thgeorgiou/ai-copy-stand/samples/README.md

# samples/

## quickrelease.stl

- **Model:** "Tripod quick release plate"
- **Author:** unwohlpol
- **Source:** <https://www.printables.com/model/204259-tripod-quick-release-plate>
- **License:** [CC BY-NC-SA 4.0](https://creativecommons.org/licenses/by-nc-sa/4.0/):
  credit the author, no commercial use, and adaptations must be shared under
  the same license.
- **Changes:** none. The file is included unmodified.

It's used only as a fitting reference. `vitamins.scad` imports it so the
clamp can be checked against a real plate profile. This file is not covered
by the project's CC0 dedication.

The clamp was designed to the plate's dimensions; it doesn't copy or adapt
this model. The rest of the project doesn't need this file, except to draw
the plate in previews. If you sell anything made from this project, leave
this file out.
