thgeorgiou/ai-copy-stand/renders/carriage_detail.png

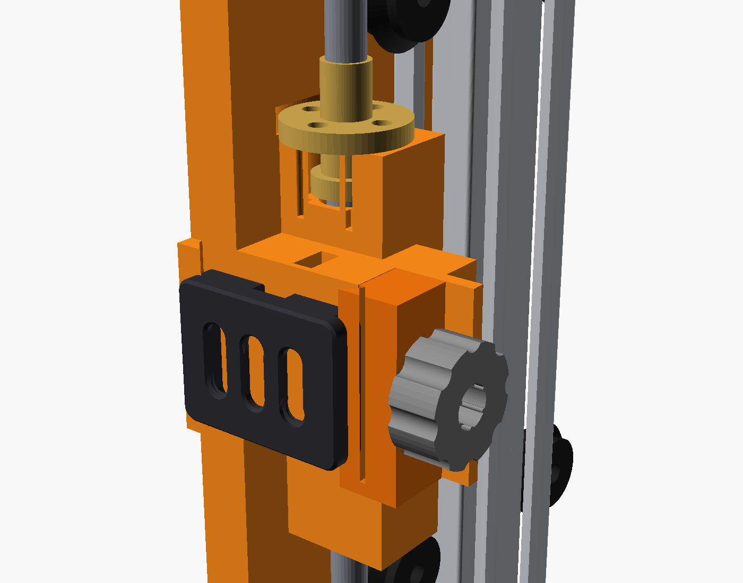
renders/carriage_detail.png
