thgeorgiou/ai-copy-stand/renders/carriage_top.png

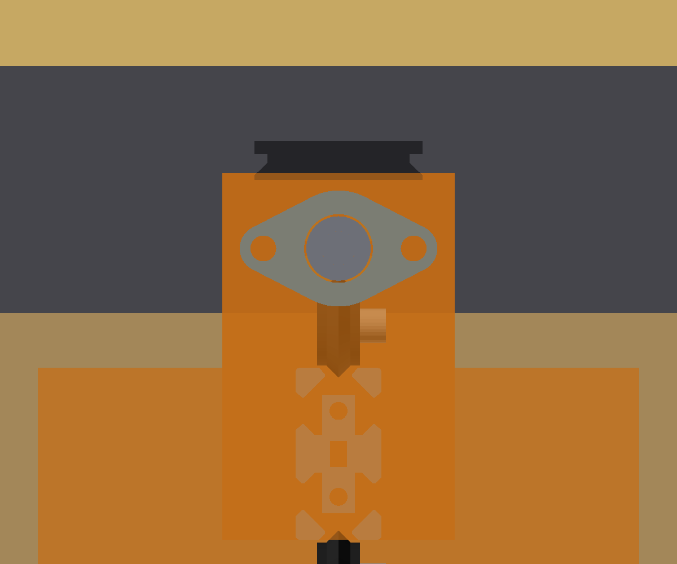
renders/carriage_top.png
