thgeorgiou/ai-copy-stand/renders/p0_coupons.png

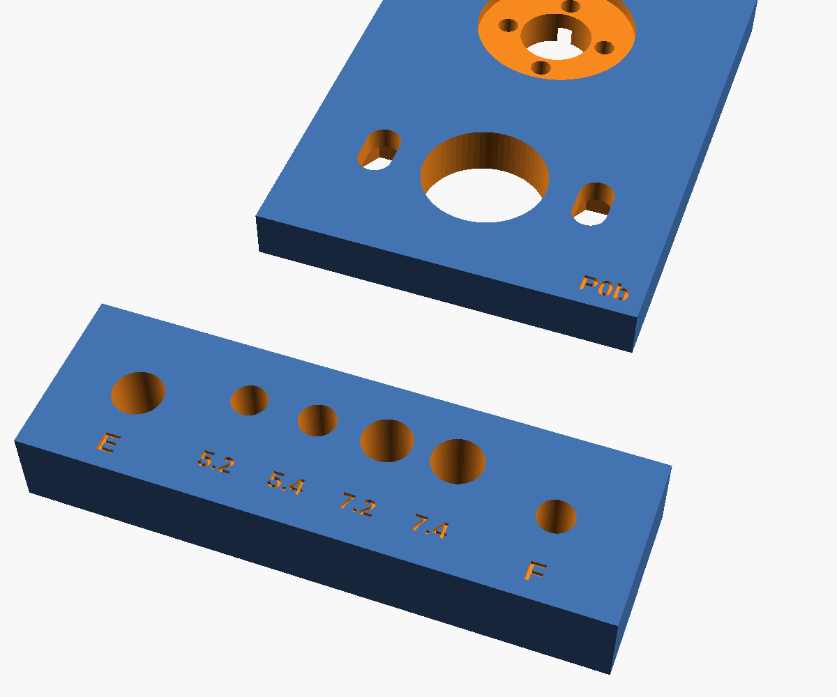
renders/p0_coupons.png
