thgeorgiou/ai-copy-stand/renders/p0_coupons_bottom.png

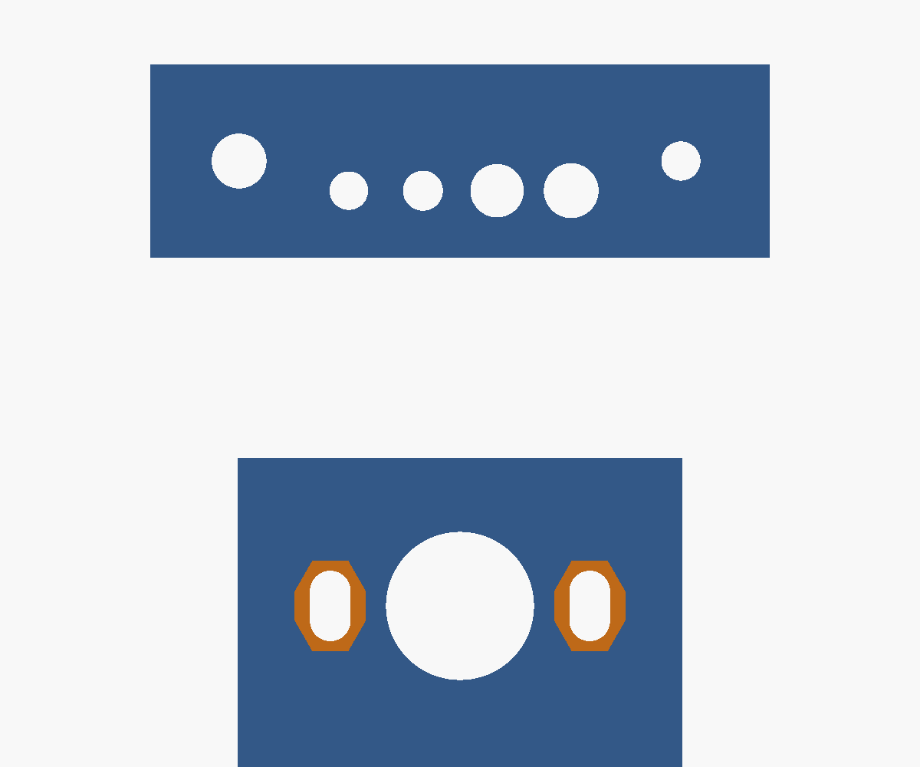
renders/p0_coupons_bottom.png
