thgeorgiou/ai-copy-stand/renders/p0a2.png

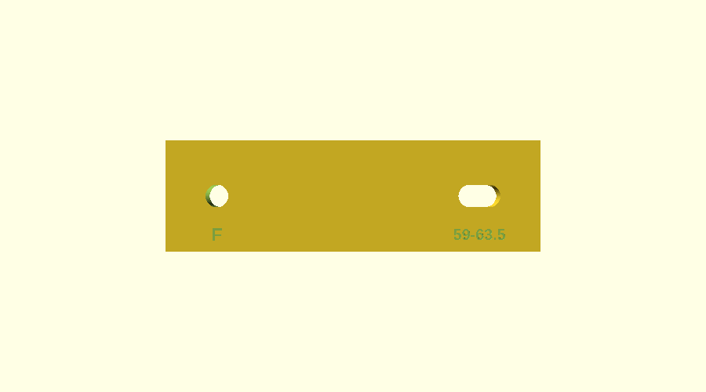
renders/p0a2.png
