thgeorgiou/ai-copy-stand/renders/p0c_end.png

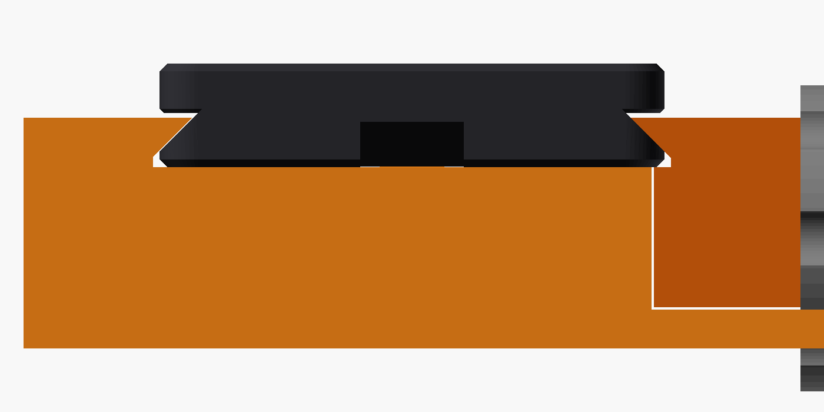
renders/p0c_end.png
