thgeorgiou/ai-copy-stand/renders/p0c_preview.png

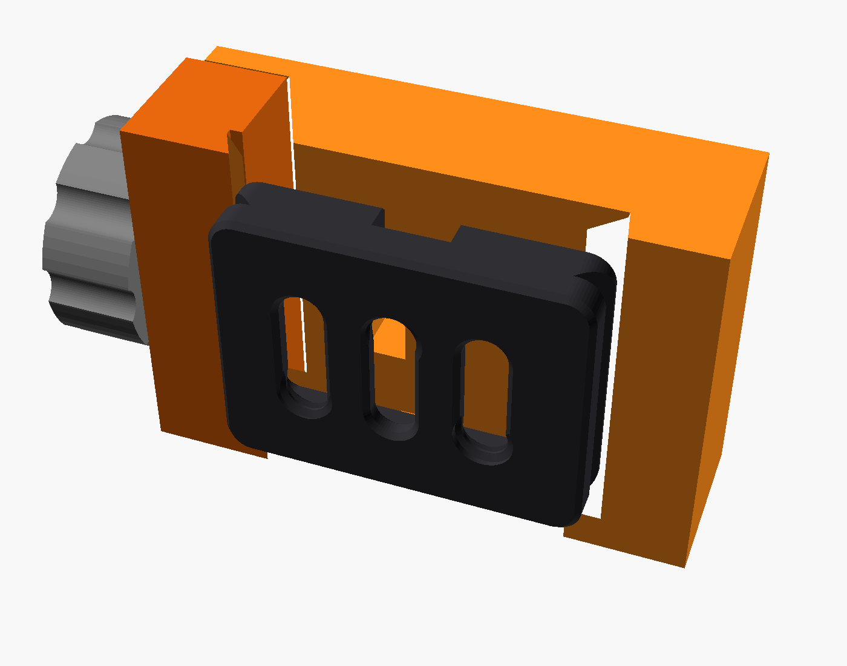
renders/p0c_preview.png
