thgeorgiou/ai-copy-stand/renders/p1_back.png

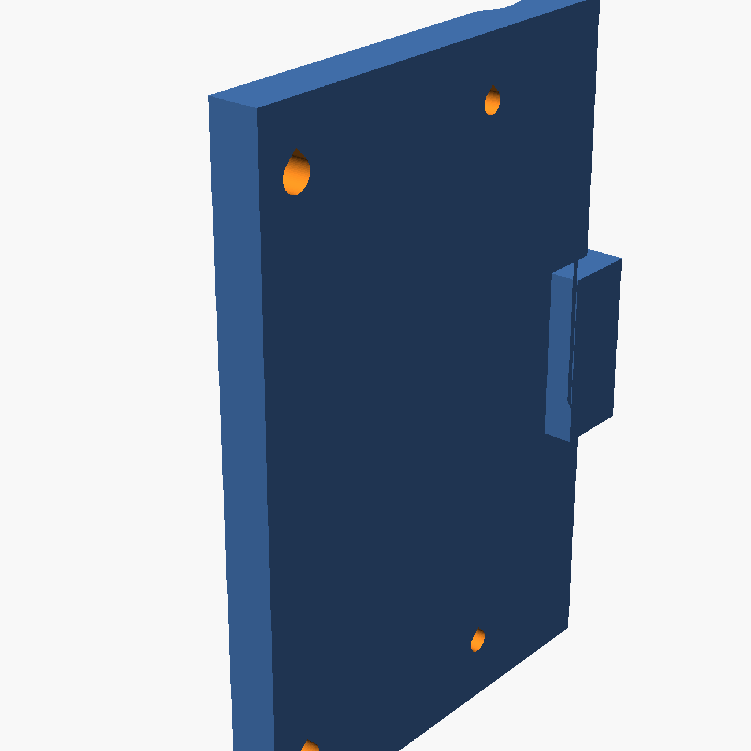
renders/p1_back.png
