thgeorgiou/ai-copy-stand/renders/p1_front.png

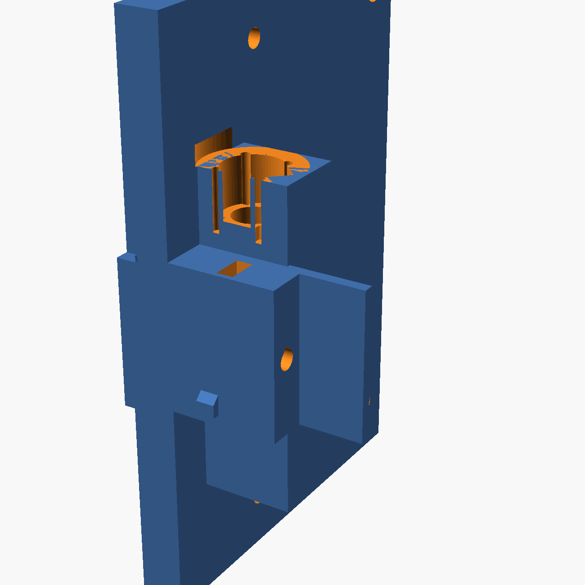
renders/p1_front.png
