thgeorgiou/ai-copy-stand/renders/p1_top.png

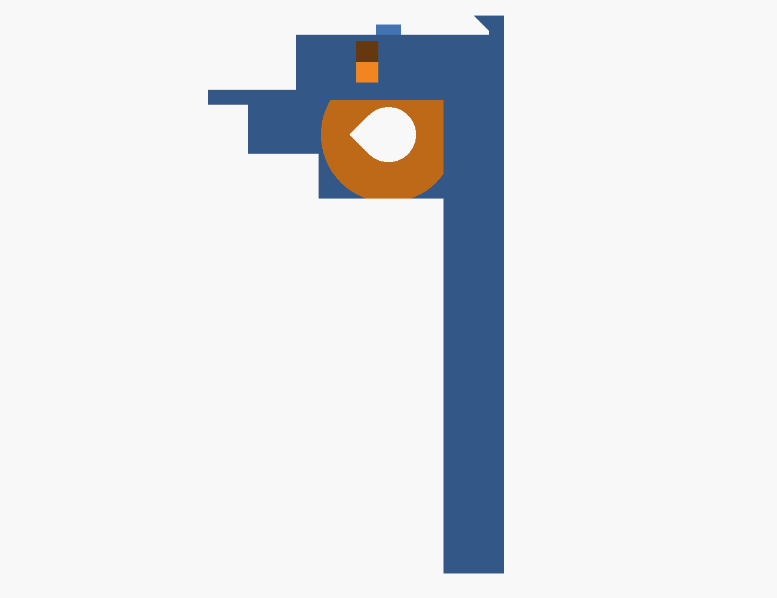
renders/p1_top.png
