thgeorgiou/ai-copy-stand/renders/p5_bottom_in_place.png

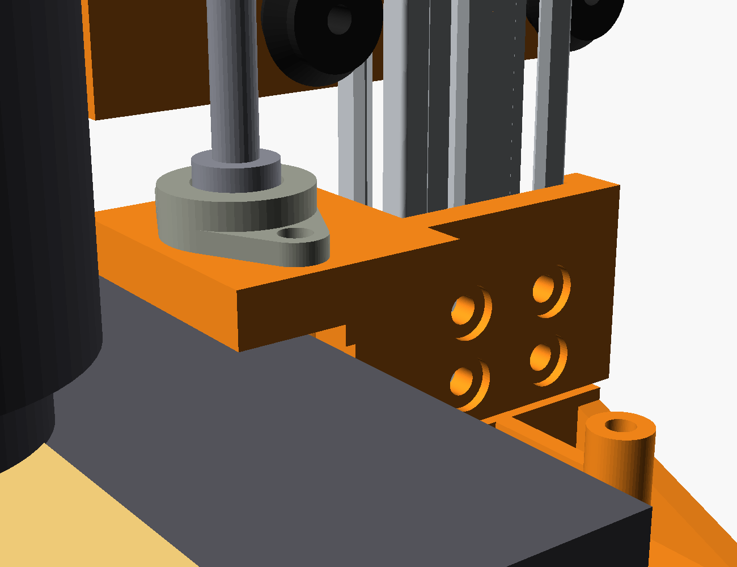
renders/p5_bottom_in_place.png
