thgeorgiou/ai-copy-stand/renders/p5_bracket.png

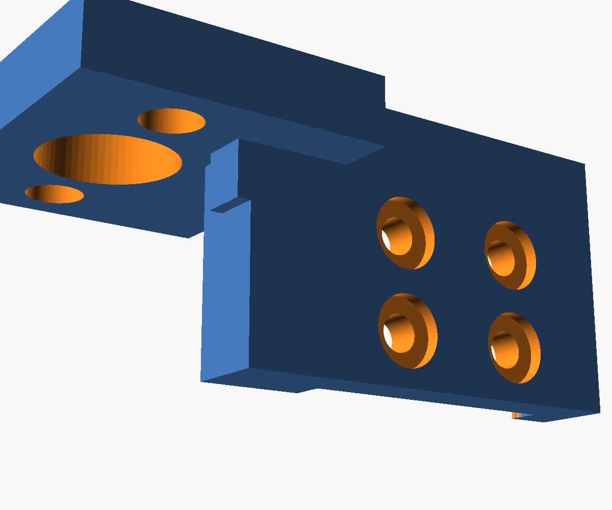
renders/p5_bracket.png
