thgeorgiou/ai-copy-stand/renders/p5_bracket_under.png

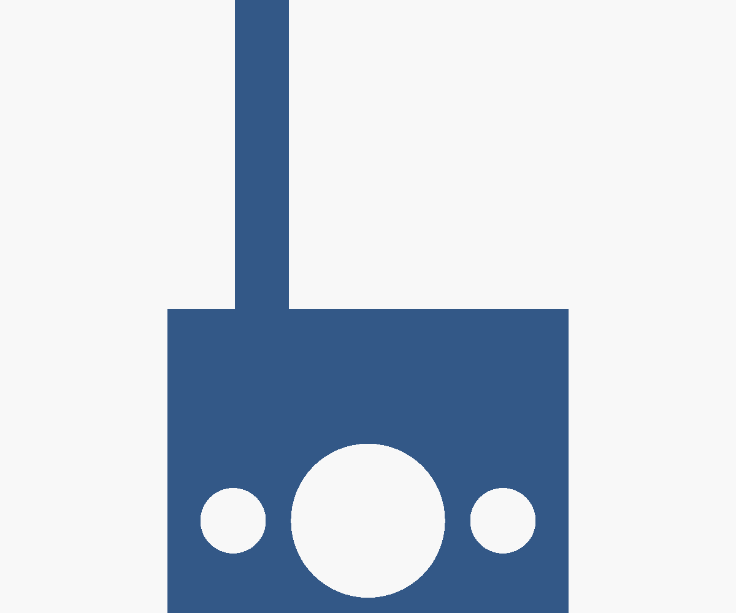
renders/p5_bracket_under.png
