thgeorgiou/ai-copy-stand/renders/p5_top_in_place.png

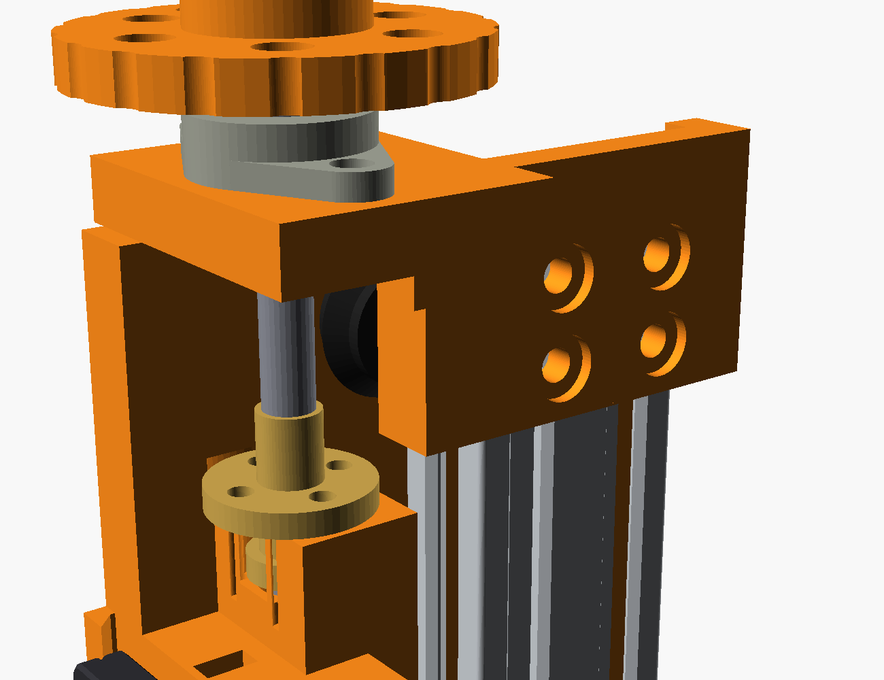
renders/p5_top_in_place.png
