thgeorgiou/ai-copy-stand/renders/p6_foot.png

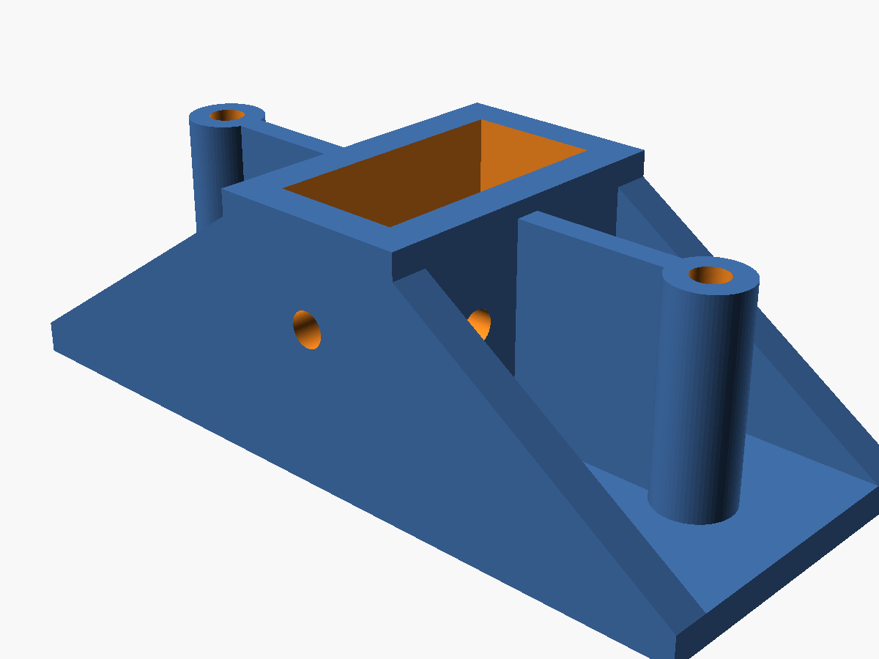
renders/p6_foot.png
