thgeorgiou/ai-copy-stand/renders/p7_handwheel.png

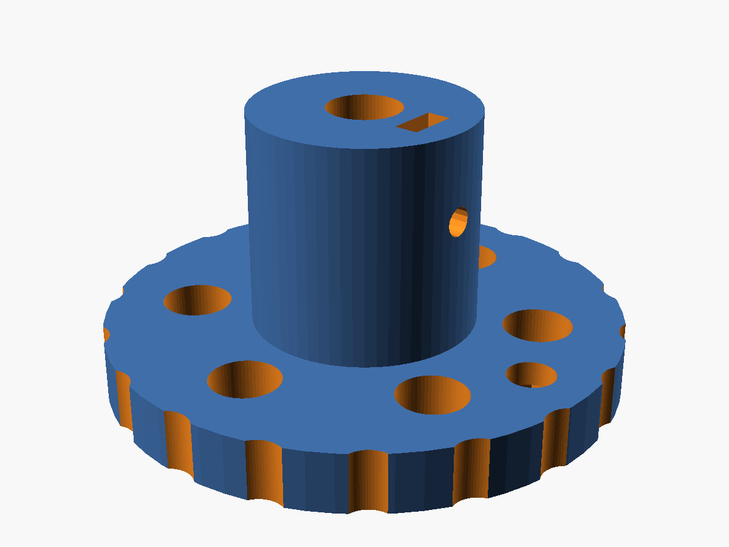
renders/p7_handwheel.png
