thgeorgiou/ai-copy-stand/renders/p7_handwheel_bottom.png

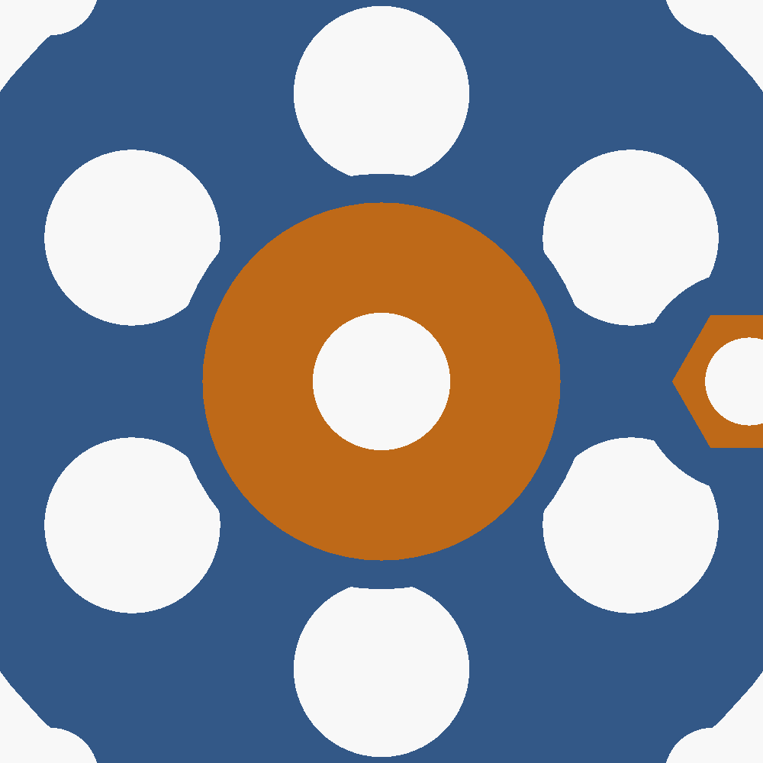
renders/p7_handwheel_bottom.png
