thgeorgiou/ai-copy-stand/renders/qr_end.png

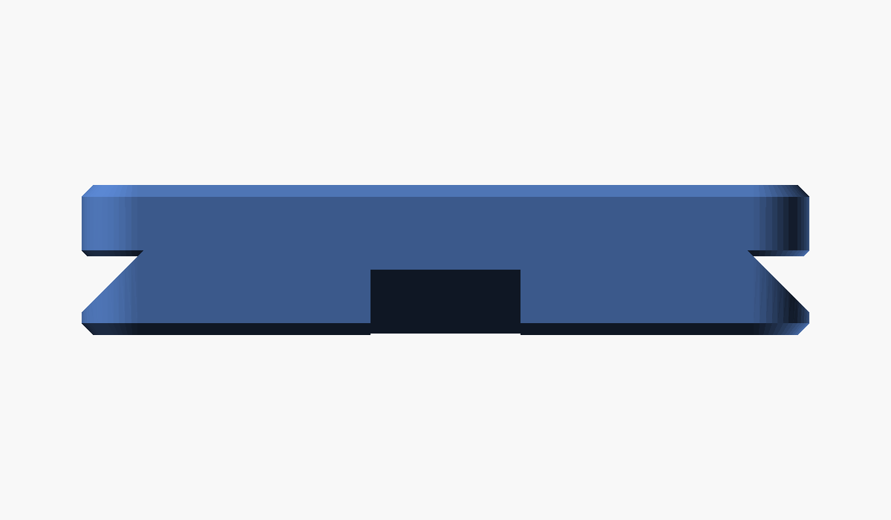
renders/qr_end.png
