thgeorgiou/ai-copy-stand/renders/qr_iso_bottom.png

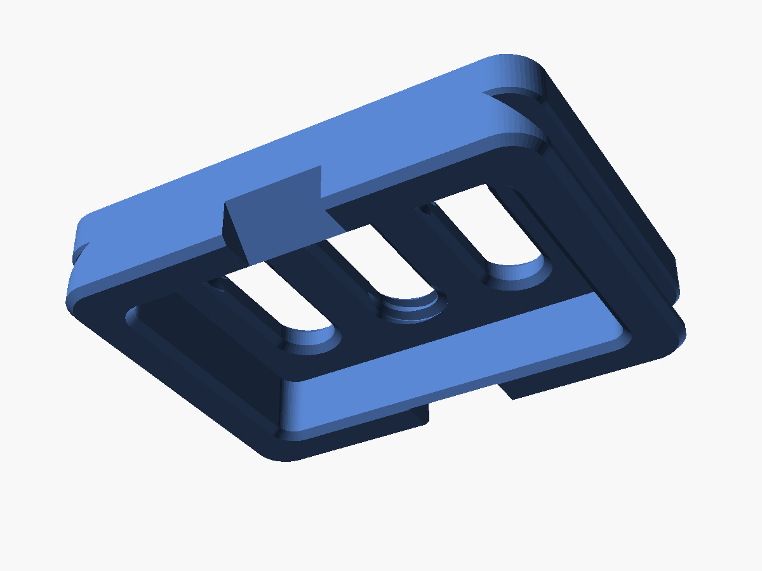
renders/qr_iso_bottom.png
