thgeorgiou/ai-copy-stand/renders/qr_iso_top.png

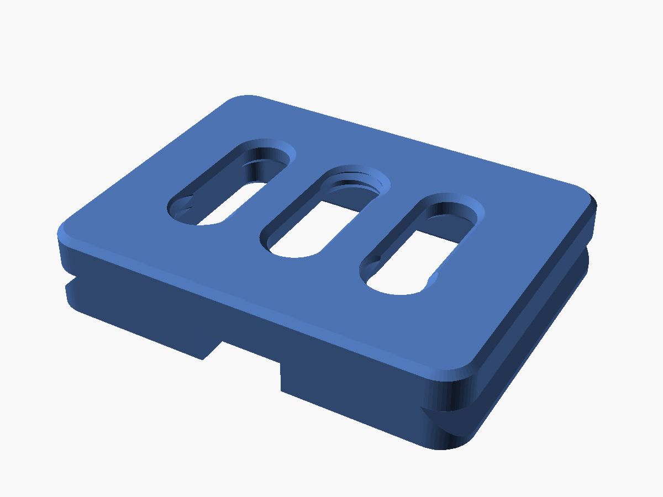
renders/qr_iso_top.png
