thgeorgiou/ai-copy-stand/renders/qr_sections.png

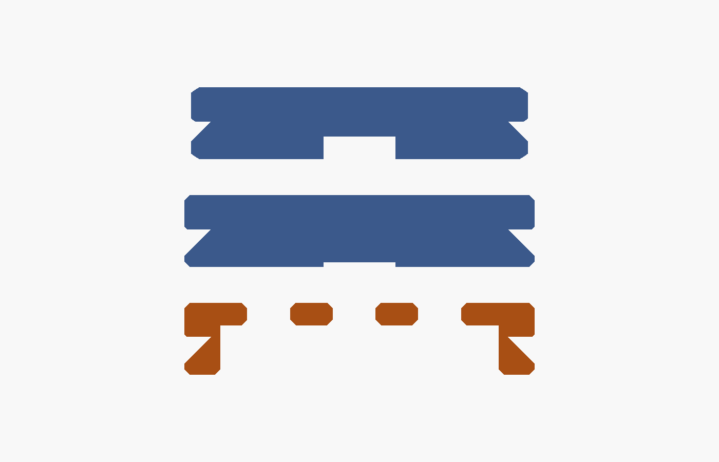
renders/qr_sections.png
