thgeorgiou/ai-copy-stand/samples/quickrelease.stl

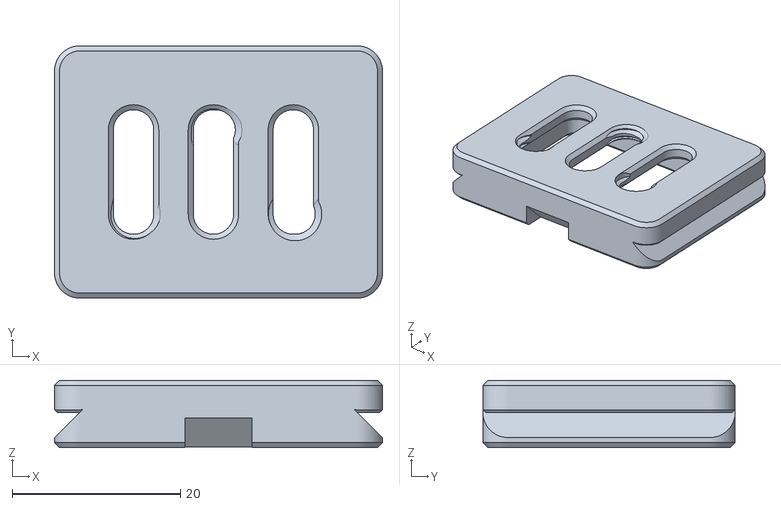
[picture p23: CAD file, 2026-10-19]
samples/quickrelease.stl
39.0 x 30.0 x 8.00
