thgeorgiou/ai-copy-stand/stl/p8_board_feet.stl

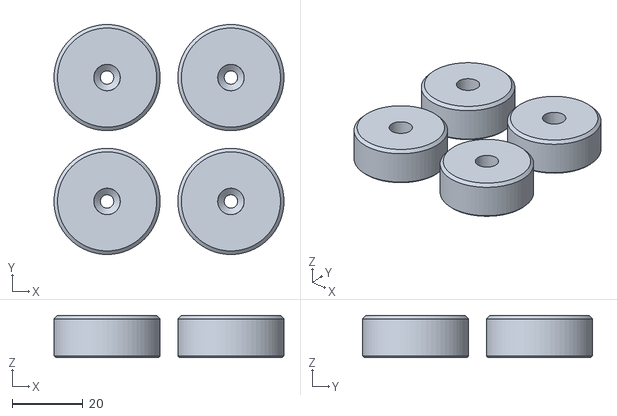
[picture p24: CAD file, 2026-10-31]
stl/p8_board_feet.stl
65.0 x 65.0 x 12.0
