thgeorgiou/ai-copy-stand/stl/p1_carriage.stl

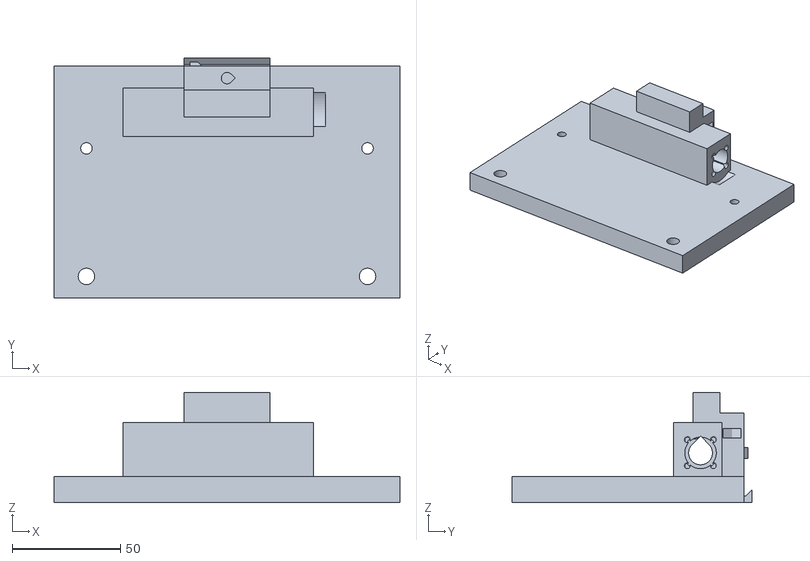
[picture p25: CAD file, 2026-10-31]
stl/p1_carriage.stl
160.0 x 111.0 x 51.0
