thgeorgiou/ai-copy-stand/stl/p3_p4_jaw_knob.stl

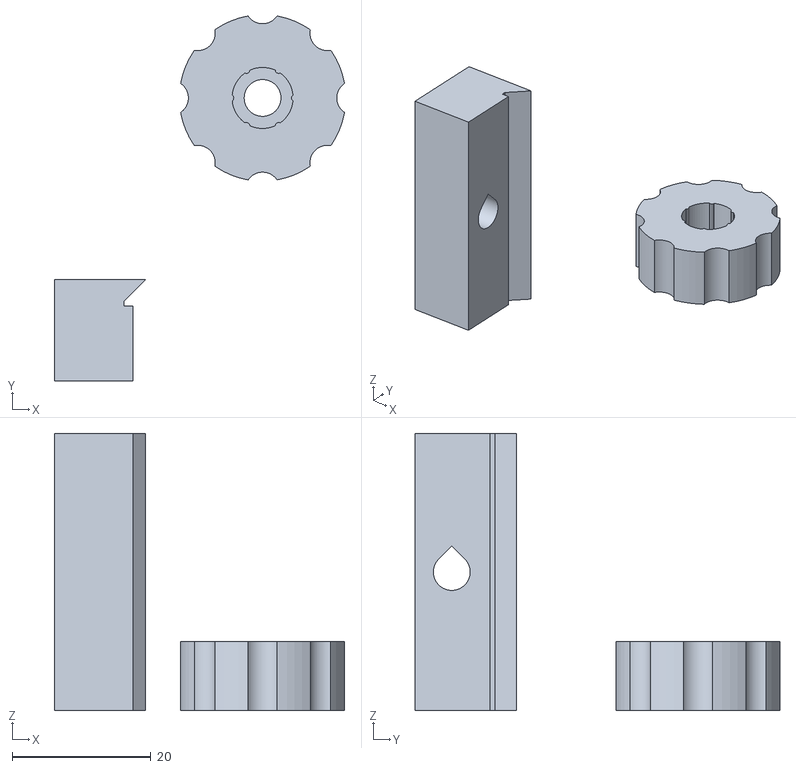
[picture p26: CAD file, 2026-10-19]
stl/p3_p4_jaw_knob.stl
41.8 x 52.6 x 40.0
