thgeorgiou/ai-copy-stand/stl/p6_foot.stl

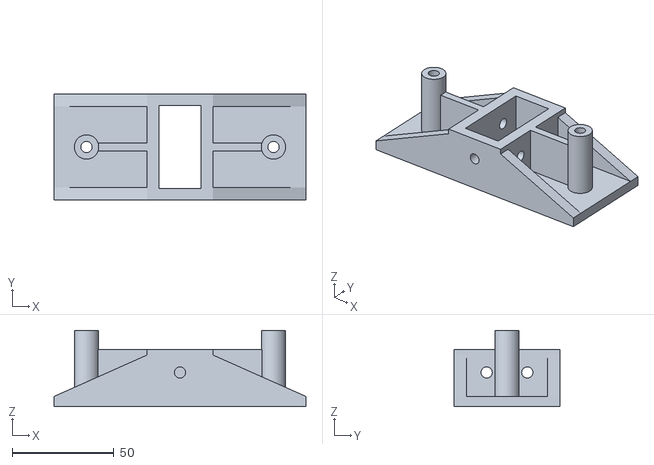
[picture p27: CAD file, 2026-10-19]
stl/p6_foot.stl
124.0 x 52.0 x 37.5
