thgeorgiou/ai-copy-stand/stl/p0b_bearing_coupon.stl

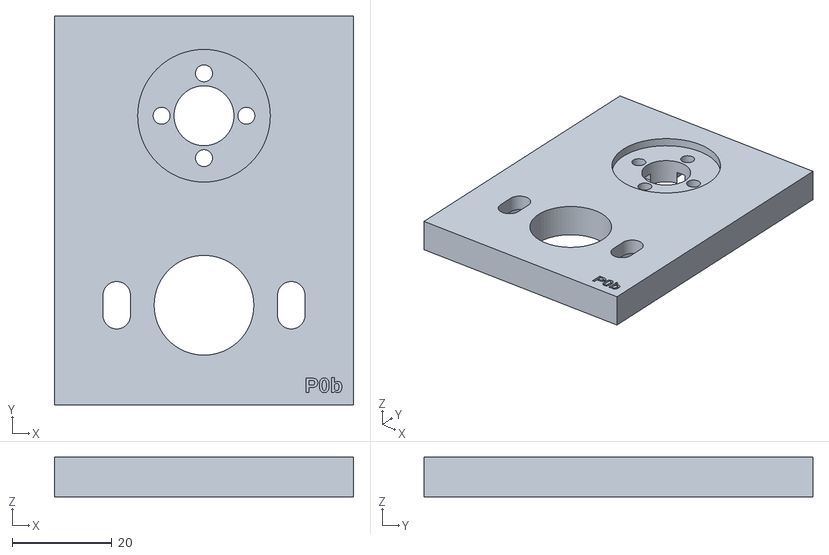
[picture p28: CAD file, 2026-10-19]
stl/p0b_bearing_coupon.stl
60.0 x 78.0 x 8.00
