thgeorgiou/ai-copy-stand/stl/p7_crank_sleeve.stl

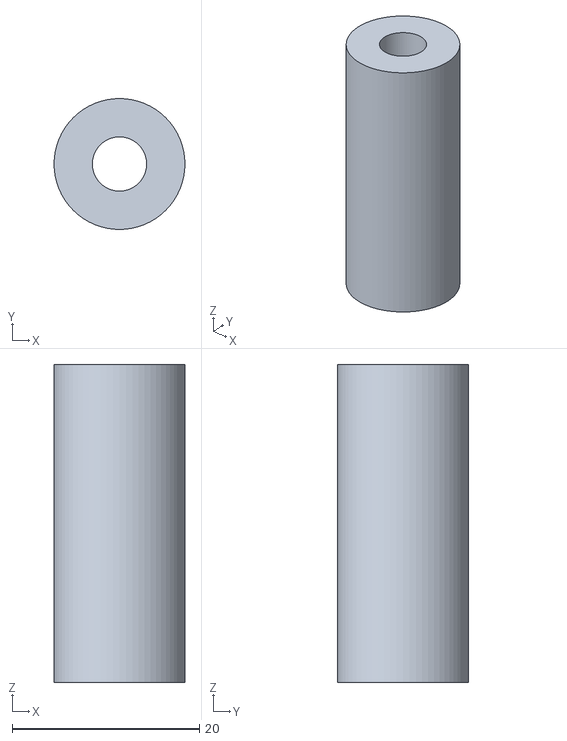
[picture p29: CAD file, 2026-10-19]
stl/p7_crank_sleeve.stl
14.0 x 14.0 x 34.0
