thgeorgiou/ai-copy-stand/stl/p5_bearing_bracket.stl

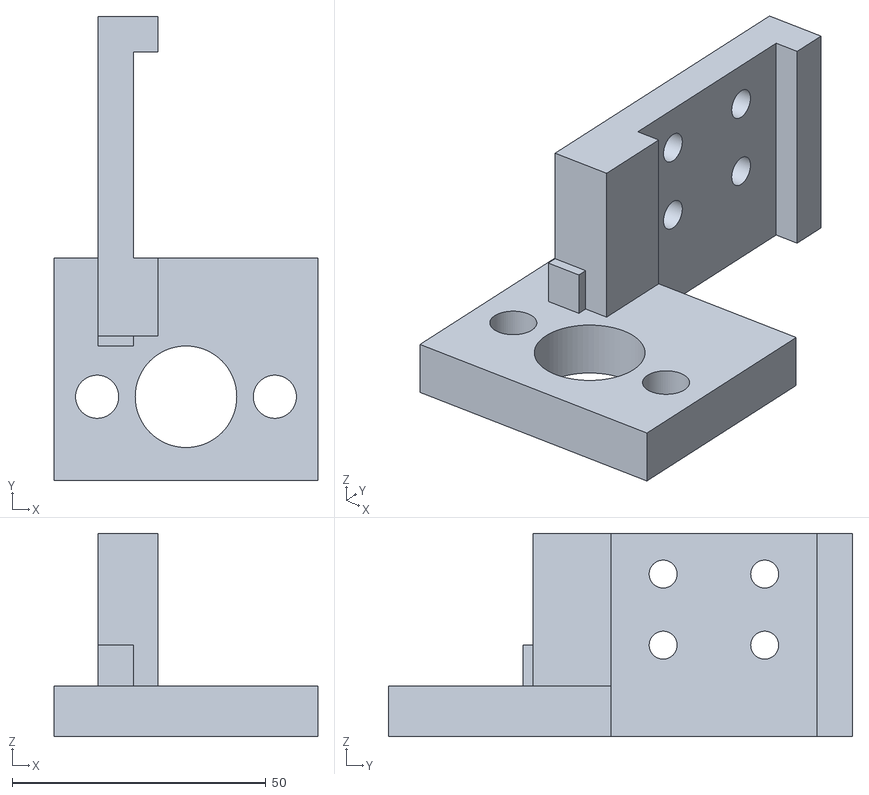
[picture p30: CAD file, 2026-10-19]
stl/p5_bearing_bracket.stl
52.0 x 91.4 x 40.0
