thgeorgiou/ai-copy-stand/stl/p7_handwheel.stl

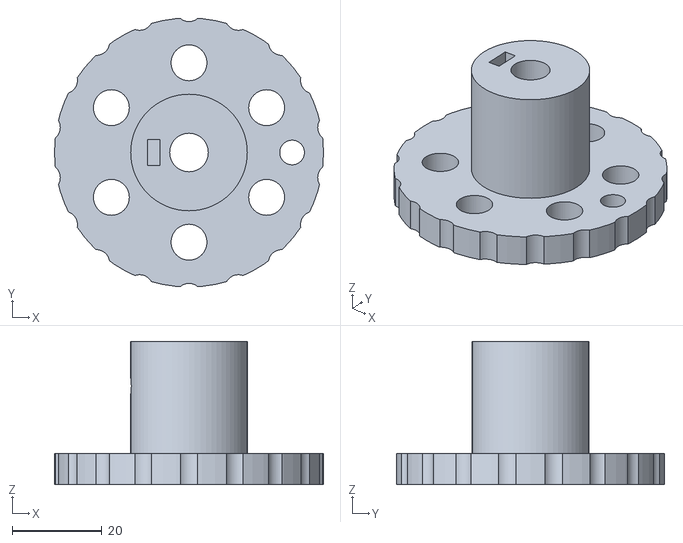
[picture p31: CAD file, 2026-10-19]
stl/p7_handwheel.stl
60.0 x 59.8 x 32.0
