thgeorgiou/ai-copy-stand/stl/p0a2_wheel_slot_coupon.stl

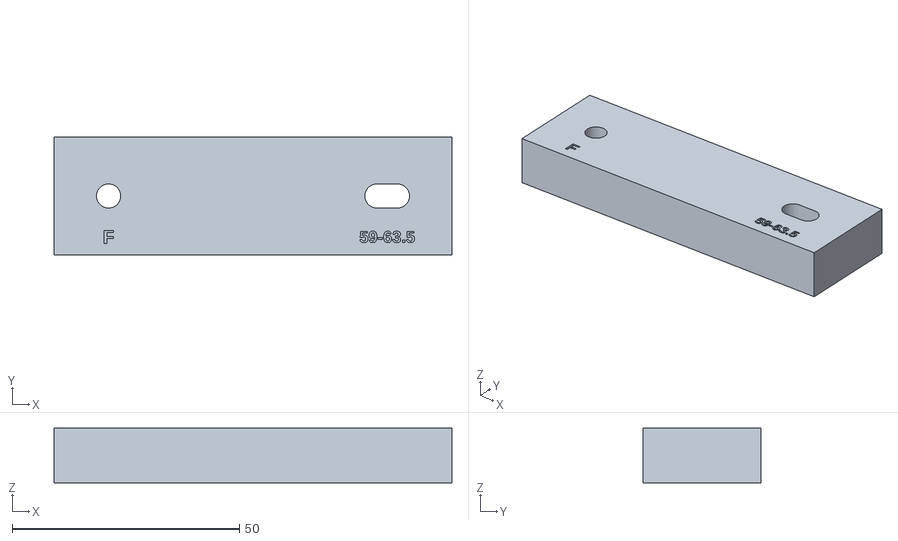
[picture p32: CAD file, 2026-10-19]
stl/p0a2_wheel_slot_coupon.stl
87.5 x 26.0 x 12.0
