thgeorgiou/ai-copy-stand/stl/p0c_clamp_coupon.stl

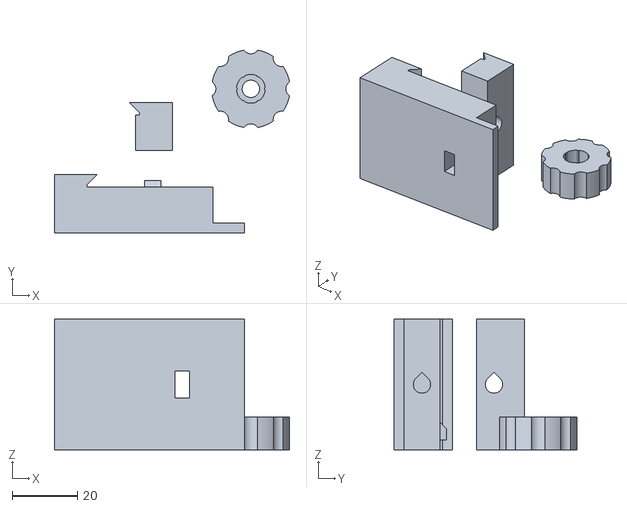
[picture p33: CAD file, 2026-10-19]
stl/p0c_clamp_coupon.stl
71.8 x 55.8 x 40.0
