thgeorgiou/ai-copy-stand/stl/p0a_wheel_coupon.stl

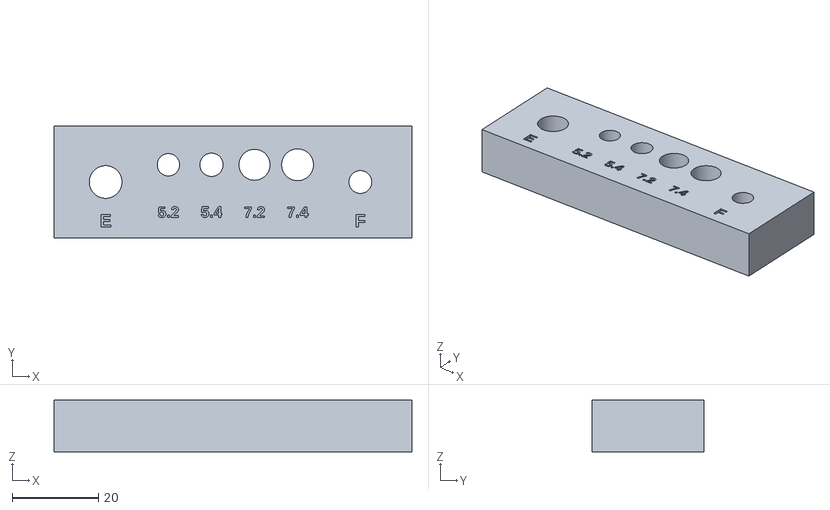
[picture p34: CAD file, 2026-10-19]
stl/p0a_wheel_coupon.stl
83.2 x 26.0 x 12.0
