thgeorgiou/ai-copy-stand/guide/build/params_echo.scad

include <../../params.scad>
use <../../parts/p8_board_feet.scad>
echo(str("PARAMS{",
 "\"wheel_y\":", wheel_y, ",\"screw_y\":", screw_y, ",\"clamp_face_y\":", clamp_face_y,
 ",\"axis_y\":", axis_y, ",\"plate_x0\":", carriage_plate_x0, ",\"plate_t\":", carriage_plate_t,
 ",\"wheelbase\":", carriage_wheelbase, ",\"nut_seat_z\":", nut_seat_z, ",\"abn_flange_t\":", abn_flange_t,
 ",\"abn_bcd\":", abn_bcd, ",\"bolt_y\":", bolt_y, ",\"jaw_out_x\":", jaw_out_x, ",\"nut_x0\":", nut_x0,
 ",\"bottom_z\":", bottom_bracket_z, ",\"top_z\":", top_bracket_z, ",\"bracket_t\":", bracket_t,
 ",\"kfl_pitch\":", kfl_pitch, ",\"kfl_flange_t\":", kfl_flange_t, ",\"kfl_housing_h\":", kfl_housing_h,
 ",\"kfl_race_proud\":", kfl_race_proud, ",\"screw_len\":", screw_len, ",\"beam_len\":", beam_len,
 ",\"wheel_cbore_h\":", wheel_cbore_h, ",\"knob_h\":", knob_h, ",\"head_h\":", head_h,
 ",\"pn_len\":", pn_len, ",\"pn_ring_h\":", pn_ring_h, ",\"cam_socket\":", cam_socket_from_mount,
 ",\"sensor_z\":", sensor_z, ",\"mft_flange\":", mft_flange, ",\"holder_film_from_back\":", holder_film_from_back,
 ",\"board_t\":", board_t, ",\"plate_l\":", plate_l, ",\"plate_t\":", plate_t,
 ",\"board_foot_h\":", board_foot_h, ",\"foot_xy\":", board_foot_xy(),
 "}PARAMS"));
