thgeorgiou/ai-copy-stand/guide/assembly_guide.pdf

ASSEMBLY GUIDE

# Film-scanning copy stand

2040 V-slot column on an APTITLIG board, printed carriage on V-wheels, Tr8 leadscrew, Arca clamp for the Sirui TY-C10.

Tools

- Hex keys 2.5, 3 and 4 mm (M3 socket, M5 low-profile, M5 socket heads)
- 8 mm spanner for M5 nuts, and one to fit the eccentric spacers’ hex
- Drill with 5.5 mm and 2.5 mm bits for the board
- A vice or clamp and a socket of about 14 mm, to press the bearings
- Ruler or calipers, a small square, a marker

Hardware sizes are in the step that uses them. Pages show the new parts in orange; parts fitted earlier are beige.

Left and right are as seen from the front, where you stand to use it. The carriage rides on the beam’s left-hand face; the brackets and the clamp knob are on the right.

P7 handwheel
P5 top bracket

Tr8 leadscrew

P1 carriage

P5 bottom bracket

P6 foot
film holder

## Parts and hardware

Qty | Hardware | Where
5 | M5×30 socket head | wheels, clamp
4 | M5×25 socket head | KFL08s
3 | M5×60 socket head | board, crank
8 | M5×10 low-profile | brackets
5 | M5×12 low-profile | foot
13 | M5 drop-in T-nut | foot, brackets
10 | M5 nut | KFL08s, board, clamp, crank
10 + 2 M5 washer + 2 large ones | KFL08s, under the board
4 | M3×12–16 | anti-backlash nut
4 | M3×8–10 | brass nut
1 + 1 | M3×10 + M3 nut | handwheel lock
4 | 3.5×16 countersunk wood
| screw | feet
4 | V-wheel kits: wheel, 2
| bearings, shim, nylock
2 + 2 | fixed + eccentric spacers
2 | KFL08 pillow blocks
1 + 1 | Tr8×2 screw + its brass nut,
| anti-backlash nut
1 | 2040 V-slot, 500 mm;
| APTITLIG board

The wheel kits’ M5×25 bolts are too short for the carriage; use M5×30.

P1 carriage

P6 foot

P5 bracket ×2

P3 moving jaw
P4 knob

P7 handwheel

P7 crank sleeve

STEP 1

## Press the bearings into the wheels

YOU NEED

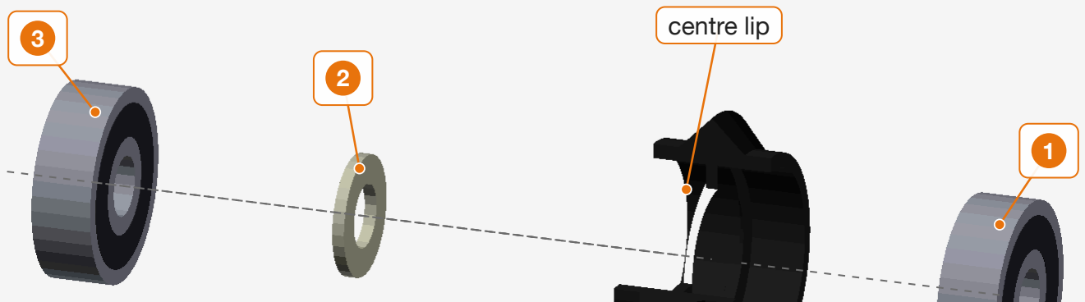
[picture p35: figure]
centre lip

×4 V-wheels, each with 2 bearings and 1 shim

### 1 Press a bearing into one face until it stops on the

centre lip. Push on the outer ring only.

### 2 Turn the wheel over and drop the shim in. It lies on

the first bearing’s inner ring, inside the lip.

### 3 Press the second bearing in until it’s flush with the

face.

In a vice, with a socket just smaller than the bearing behind it. Or pull it in with an M5 bolt, a nut and a big washer over the outer ring. Never hammer on the seal.

Check: On a bolt with the nut done up hard, the wheel still spins freely. If it goes stiff, the shim is missing.

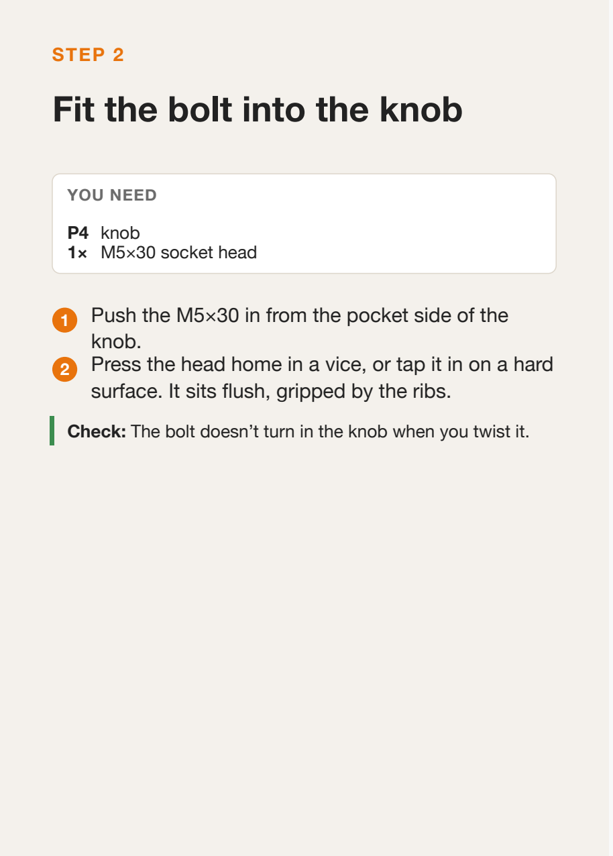
[picture p36: figure]
STEP 2 Fit the bolt into the knob; YOU NEED; P4 knob 1× M5×30 socket head; knob.
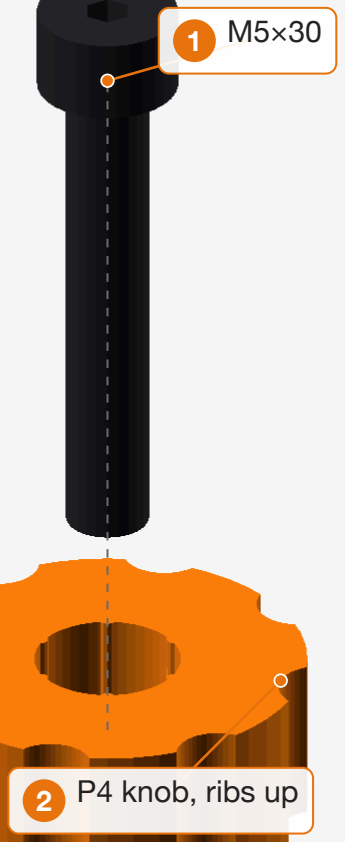
[picture p37: figure]
2 P4 knob, ribs up

### 1 Push the M5×30 in from the pocket side of the

### 2 Press the head home in a vice, or tap it in on a hard

surface. It sits flush, gripped by the ribs.

Check: The bolt doesn’t turn in the knob when you twist it.

STEP 3

## Fit the foot to the beam

YOU NEED

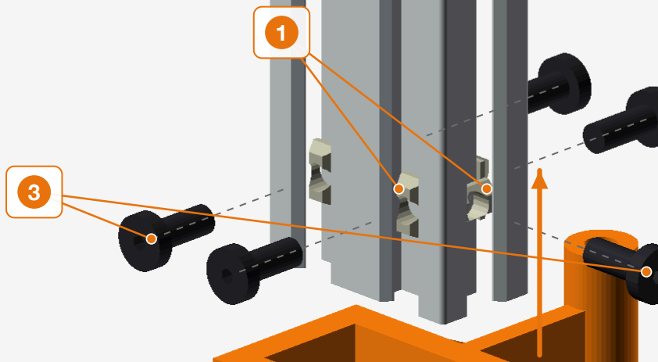
[picture p38: figure]

P6 foot
5× M5 drop-in T-nuts
5× M5×12 low-profile

### 1 Drop a T-nut into each slot near the bottom of the

beam: both slots on each side face, and the one on the back. Twist each one so it locks across the slot.
2 Slide the foot up over the bottom end of the beam. The beam’s end sits flush with the foot’s base, so both stand on the board.

### 3 Bolt through the collar into each T-nut, sliding the T-

nut under its hole first. Snug only for now.

The front face (the one with a single slot, facing you) stays clear: the leadscrew and film holder are on that side.

Check: Stand it on a flat table while you tighten, so the beam end and the foot’s base both touch.
2

STEP 4

## Bolt the foot to the board

YOU NEED

2× M5×60 socket head
2× M5 nuts + large washers
5.5 mm drill

1 Stand the foot on the board, centred left–right, back edge 4 mm from the board’s back edge. Mark through the two bosses and drill 5.5 mm. The holes end up 30 mm from the back edge and 179 mm from each side.

### 2 M5×60 down through each boss, then a large

washer and a nut underneath.

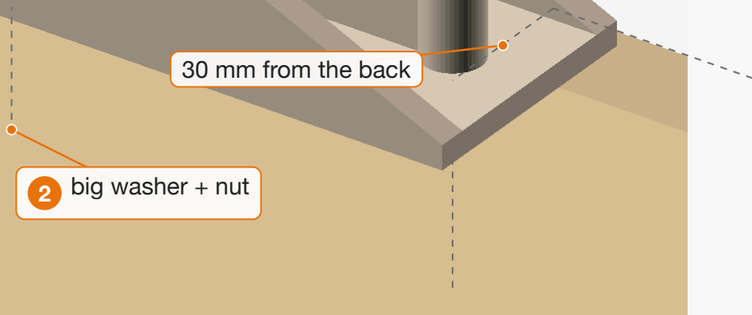
[picture p39: figure]
2 big washer + nut; 30 mm from the back

Drill from the top with a scrap block under the board, so the bamboo doesn’t split out on the underside.

Check: The beam stands square to the board in both directions. If not, shim under the foot.

### 1 M5×60

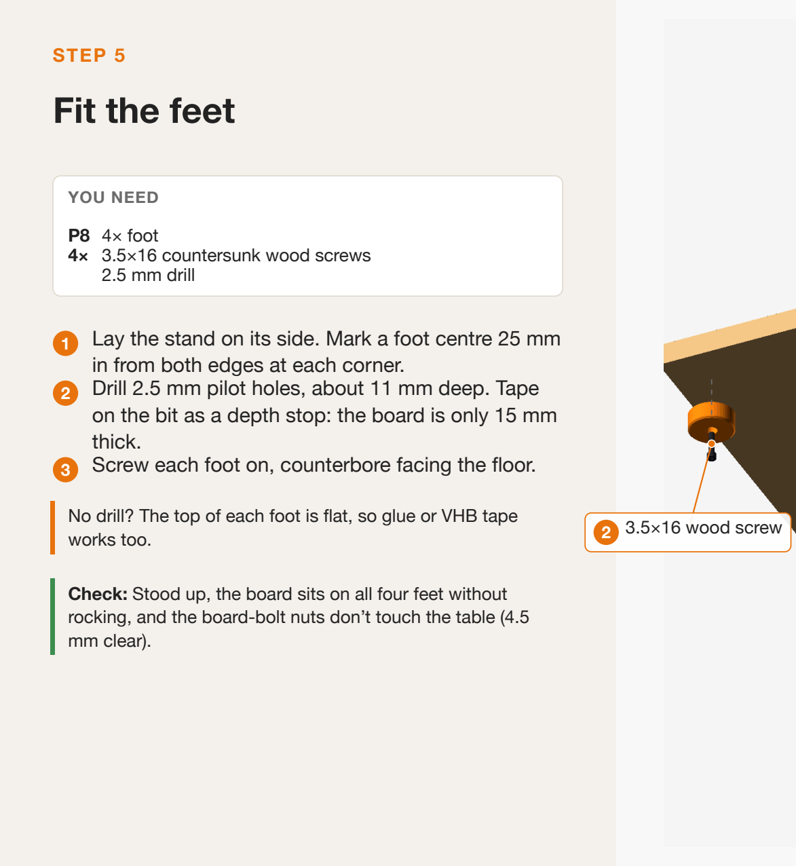
[picture p40: figure]
STEP 5 Fit the feet; YOU NEED; P8 4× foot 4× 3.5×16 countersunk wood screws 2.5 mm drill; in from both edges at each corner.; thick.; works too.; mm clear).; 3.5×16 wood screw
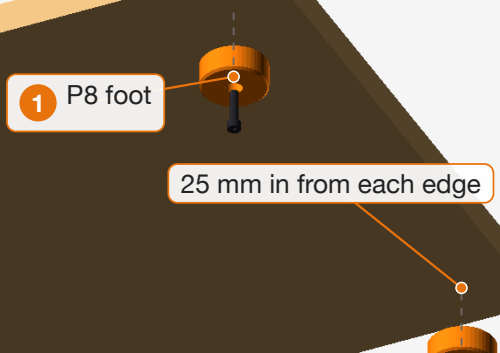
[picture p41: figure]
1 P8 foot; 25 mm in from each edge

### 1 Lay the stand on its side. Mark a foot centre 25 mm

### 2 Drill 2.5 mm pilot holes, about 11 mm deep. Tape

on the bit as a depth stop: the board is only 15 mm

3 Screw each foot on, counterbore facing the floor.

No drill? The top of each foot is flat, so glue or VHB tape

Check: Stood up, the board sits on all four feet without rocking, and the board-bolt nuts don’t touch the table (4.5

### 3 bolt tails clear by 4.5 mm

STEP 6

## Fit the bottom bearing bracket

YOU NEED

P5 bearing bracket
4× M5 drop-in T-nuts
4× M5×10 low-profile

### 1 Put two T-nuts into each slot on the beam’s right-

hand face (seen from the front), about 40–55 mm up.

### 2 Bolt through the skirt’s four recessed holes into the

T-nuts, loosely.

### 3 The bracket hooks round the beam’s two right-

hand corners. Slide it until the plate’s underside is 60 mm above the board and level, then tighten.

Cut a 60 mm block, or stack something that height, to rest the bracket on while you tighten. The film holder (50 mm) slides in under it later.

1

2

### 3 P5

60 mm

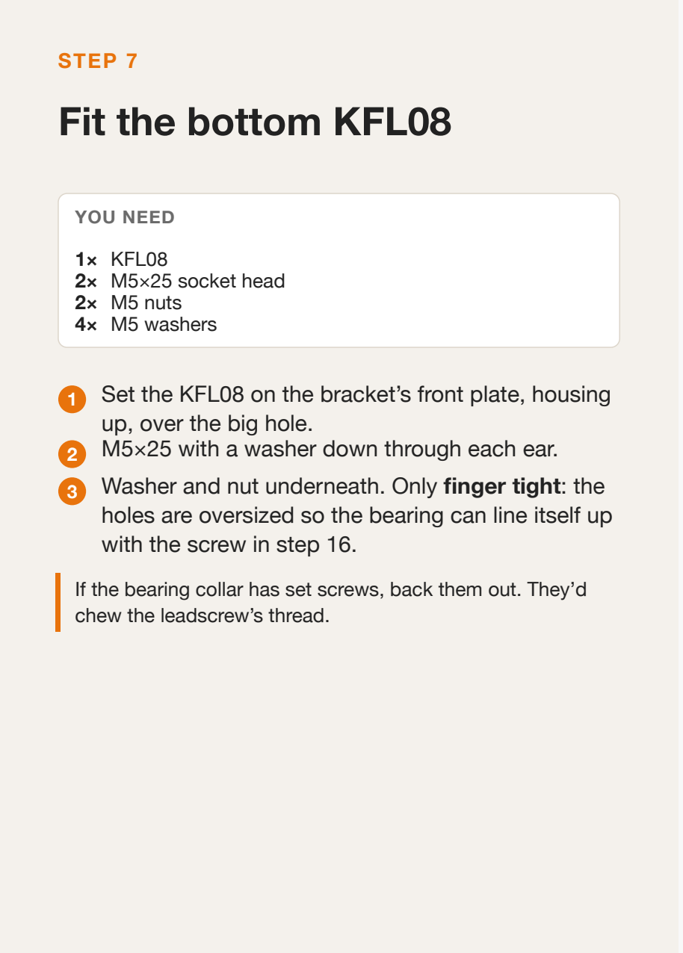
[picture p42: figure]
STEP 7 Fit the bottom KFL08; YOU NEED; 1× KFL08 2× M5×25 socket head 2× M5 nuts 4× M5 washers; up, over the big hole.; with the screw in step 16.; chew the leadscrew’s thread.
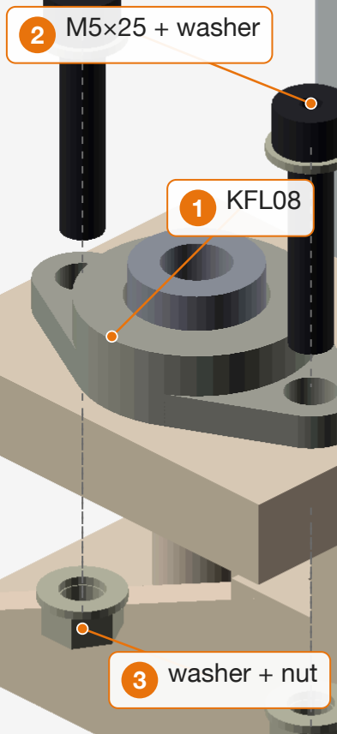
[picture p43: figure]
1 KFL08; 2 M5×25 + washer; 3 washer + nut

### 1 Set the KFL08 on the bracket’s front plate, housing

2 M5×25 with a washer down through each ear.

### 3 Washer and nut underneath. Only finger tight: the

holes are oversized so the bearing can line itself up

If the bearing collar has set screws, back them out. They’d

STEP 8

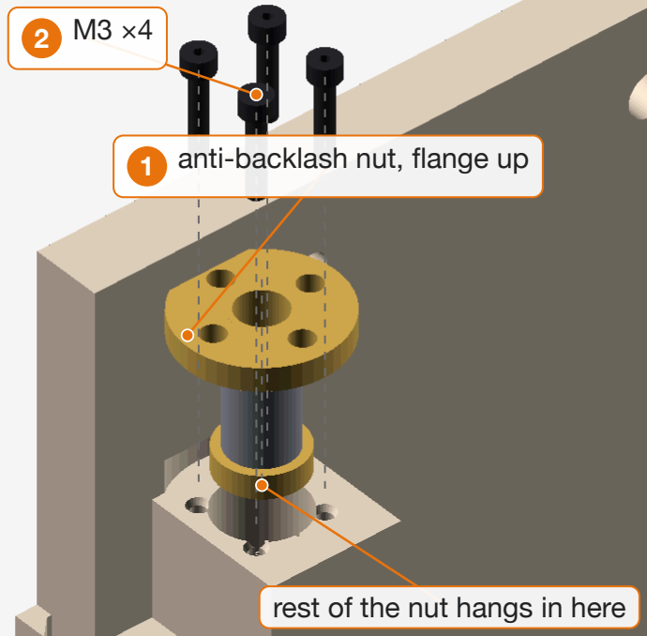
[picture p44: figure]
anti-backlash nut, flange up; rest of the nut hangs in here

## Fit the anti-backlash nut

YOU NEED

P1 carriage
1× anti-backlash nut
4× M3×12–16

### 1 Nut flange up, with everything else (body, spring

and end piece) hanging down into the bore in the tower.

### 2 Press the flange down onto its seat against the

spring and turn it so its holes line up with the four pilot holes.

### 3 Start two opposite M3s first while holding the

flange down, then the other two. They cut their own thread in the plastic: drive slowly and stop as soon as the flange is clamped.

Do this before fitting the wheels. The upper front wheel covers the two back screws.

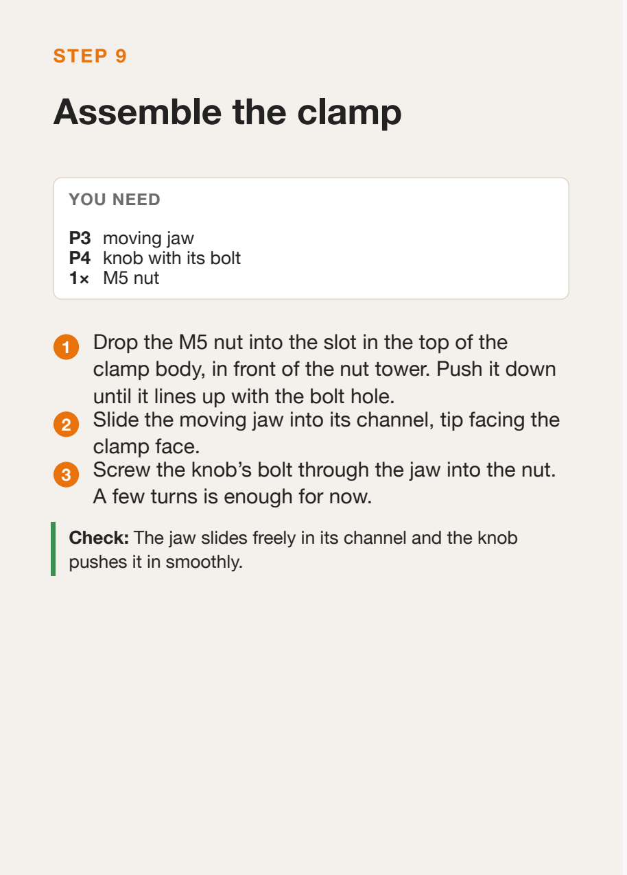
[picture p45: figure]
STEP 9 Assemble the clamp; YOU NEED; P3 moving jaw P4 knob with its bolt 1× M5 nut; until it lines up with the bolt hole.; clamp face.; A few turns is enough for now.; pushes it in smoothly.
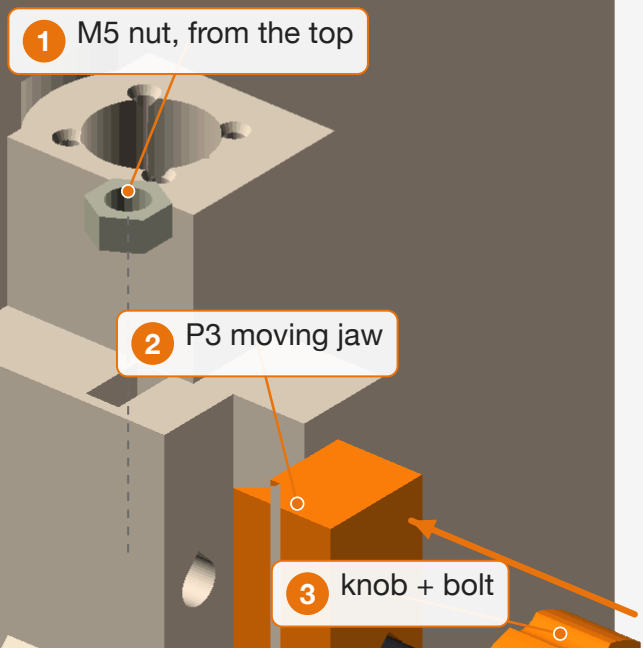
[picture p46: figure]
1 M5 nut, from the top; 2 P3 moving jaw; knob + bolt

### 1 Drop the M5 nut into the slot in the top of the

clamp body, in front of the nut tower. Push it down

### 2 Slide the moving jaw into its channel, tip facing the

3 Screw the knob’s bolt through the jaw into the nut.

Check: The jaw slides freely in its channel and the knob

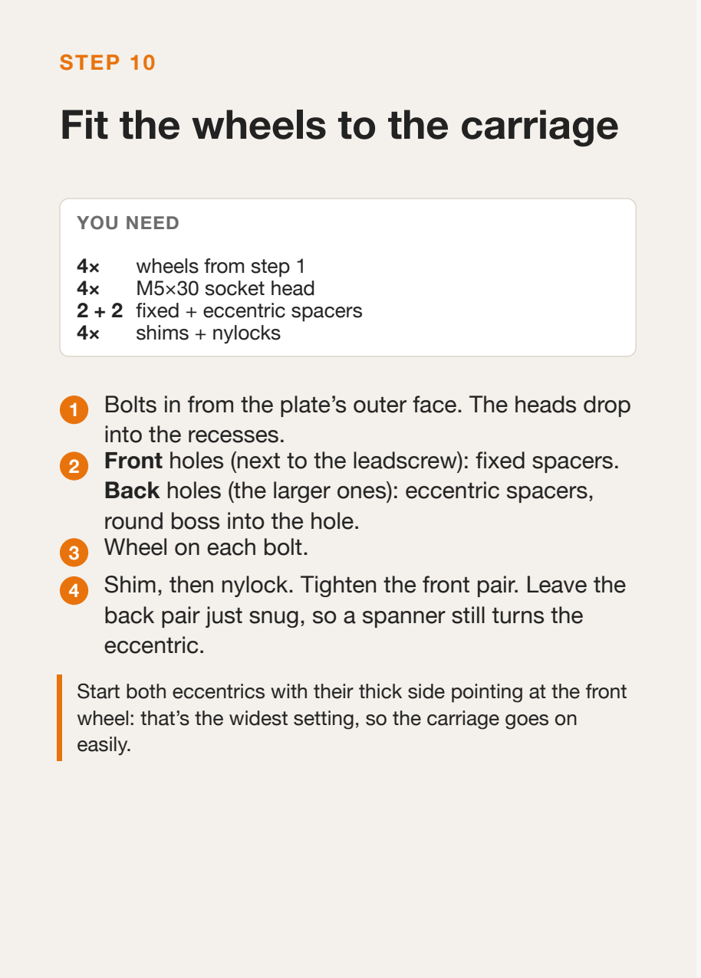
[picture p47: figure]
STEP 10 Fit the wheels to the carriage; YOU NEED; wheels from step 1; M5×30 socket head; 2 + 2 fixed + eccentric spacers; shims + nylocks; into the recesses.; round boss into the hole. 3 Wheel on each bolt.; eccentric.; easily.
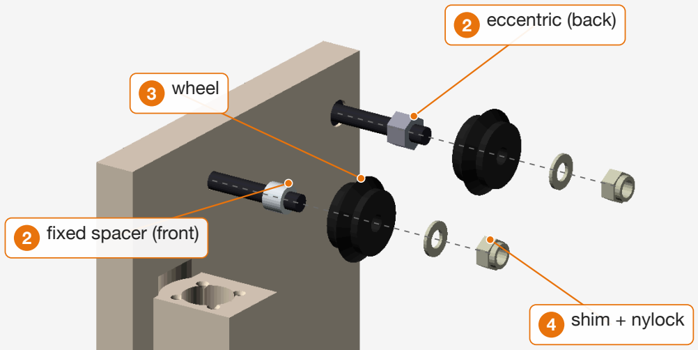
[picture p48: figure]
shim + nylock; 3 wheel; fixed spacer (front); eccentric (back)

### 1 Bolts in from the plate’s outer face. The heads drop

2 Front holes (next to the leadscrew): fixed spacers. Back holes (the larger ones): eccentric spacers,

### 4 Shim, then nylock. Tighten the front pair. Leave the

back pair just snug, so a spanner still turns the

Start both eccentrics with their thick side pointing at the front wheel: that’s the widest setting, so the carriage goes on

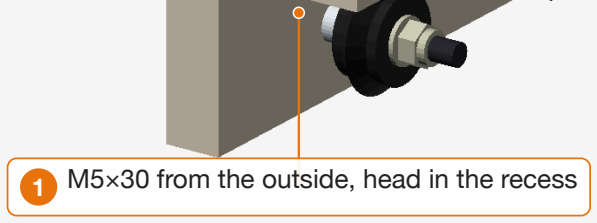
[picture p49: figure]

### 1 M5×30 from the outside, head in the recess

STEP 11

## Put the carriage on the beam

YOU NEED

carriage from steps 7–10
spanner for the eccentric hex

### 1 Turn both eccentrics by the same amount until the

carriage doesn’t rock when you twist it, the wheels stand upright, and it still rolls freely. You can just stop a wheel with a finger.

### 2 Slide the carriage on from the top end: clamp

facing the front, wheel plate on the left-hand face, knob on the right. It rolls down until it stops on the bottom bracket.

Hold the eccentric with the spanner while you tighten its nylock, then check the feel again.

Check: Too tight: wheels tilt outward, rolling drags. Too loose: it clicks or rocks.

1

2

top end of the beam

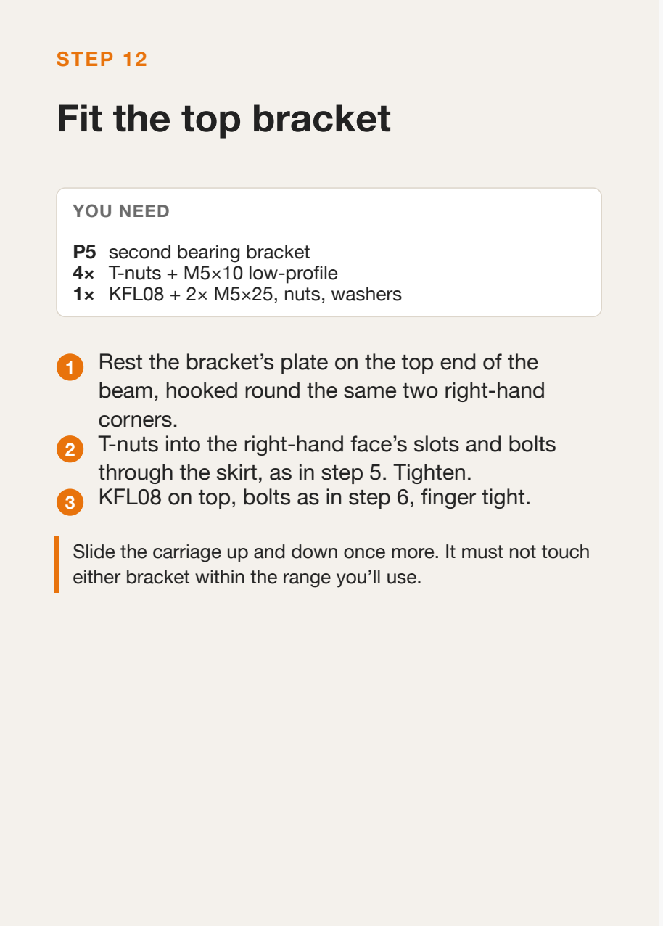
[picture p50: figure]
STEP 12 Fit the top bracket; YOU NEED; P5 second bearing bracket 4× T-nuts + M5×10 low-profile 1× KFL08 + 2× M5×25, nuts, washers; corners.
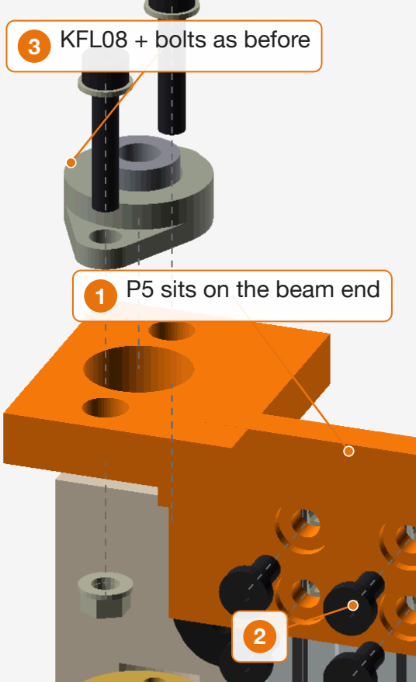
[picture p51: figure]
1 P5 sits on the beam end; 3 KFL08 + bolts as before

### 1 Rest the bracket’s plate on the top end of the

beam, hooked round the same two right-hand

### 2 T-nuts into the right-hand face’s slots and bolts

through the skirt, as in step 5. Tighten.
3 KFL08 on top, bolts as in step 6, finger tight.

Slide the carriage up and down once more. It must not touch either bracket within the range you’ll use.

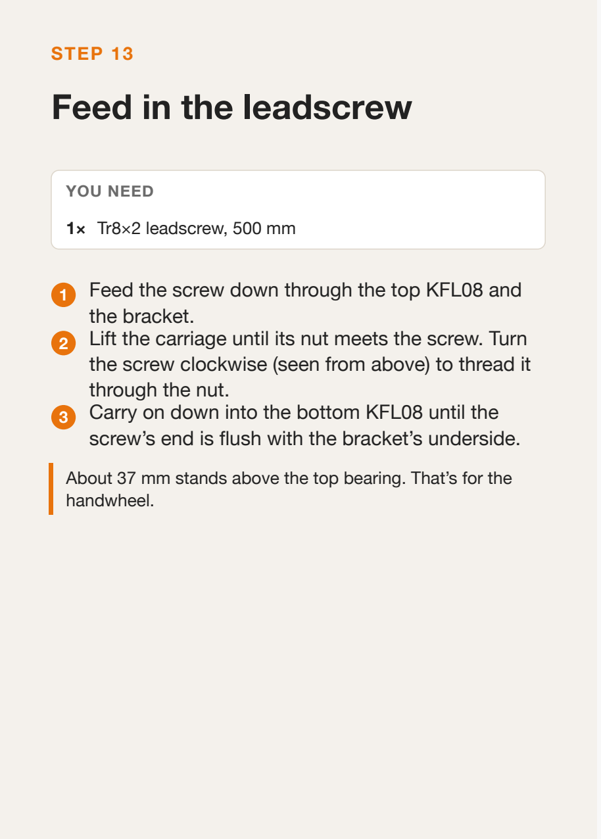
[picture p52: figure]
STEP 13 Feed in the leadscrew; YOU NEED; 1× Tr8×2 leadscrew, 500 mm; the bracket.; through the nut.; handwheel.

### 1 Feed the screw down through the top KFL08 and

### 2 Lift the carriage until its nut meets the screw. Turn

the screw clockwise (seen from above) to thread it

### 3 Carry on down into the bottom KFL08 until the

screw’s end is flush with the bracket’s underside.

About 37 mm stands above the top bearing. That’s for the

### 1 Tr8 leadscrew, from the top

2

turn to thread it through

3

end flush with the bracket underside

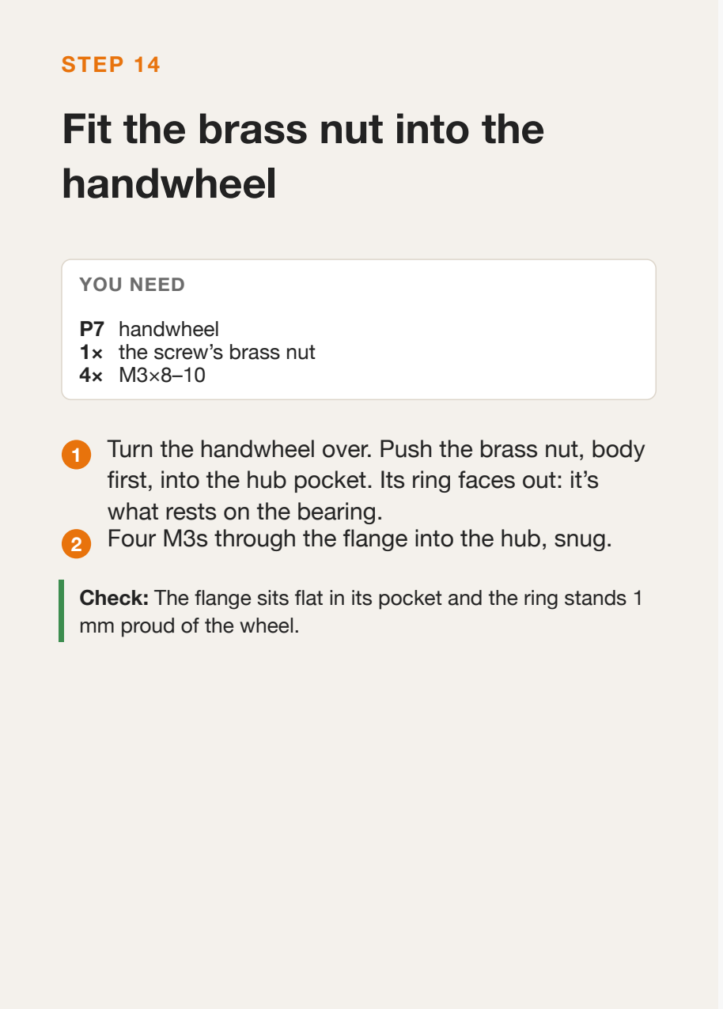
[picture p53: figure]
STEP 14 Fit the brass nut into the handwheel; YOU NEED; P7 handwheel 1× the screw’s brass nut 4× M3×8–10; what rests on the bearing.; mm proud of the wheel.
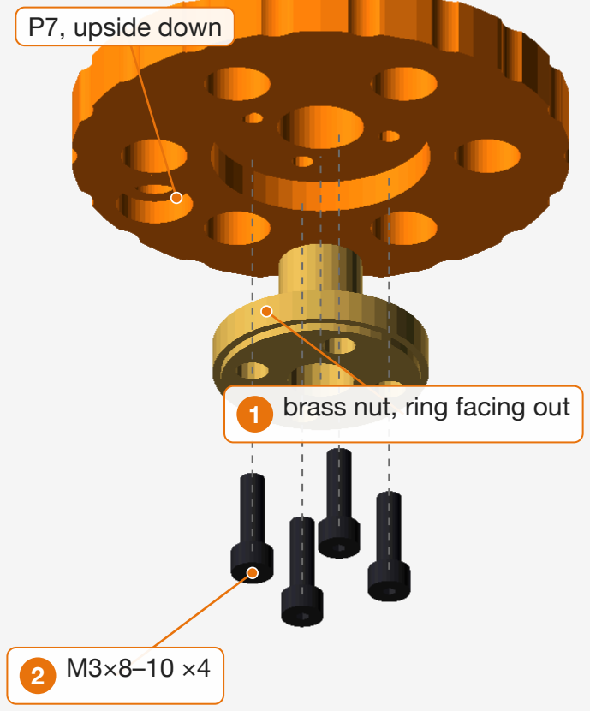
[picture p54: figure]
1 brass nut, ring facing out; P7, upside down

### 1 Turn the handwheel over. Push the brass nut, body

first, into the hub pocket. Its ring faces out: it’s

2 Four M3s through the flange into the hub, snug.

Check: The flange sits flat in its pocket and the ring stands 1

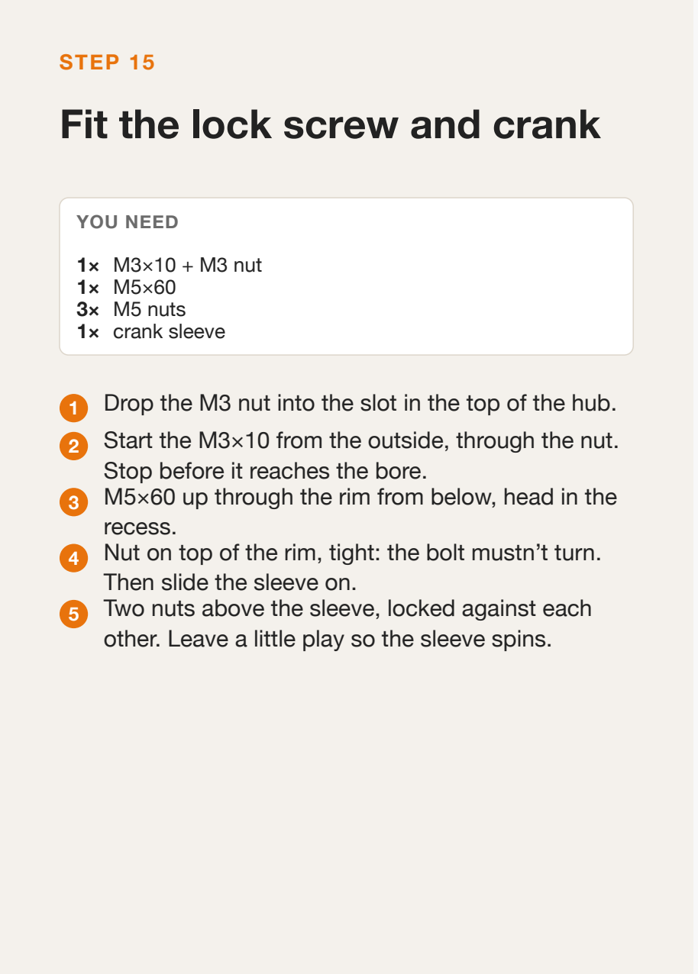
[picture p55: figure]
STEP 15 Fit the lock screw and crank; YOU NEED; 1× M3×10 + M3 nut 1× M5×60 3× M5 nuts 1× crank sleeve; Stop before it reaches the bore.; recess.; Then slide the sleeve on.
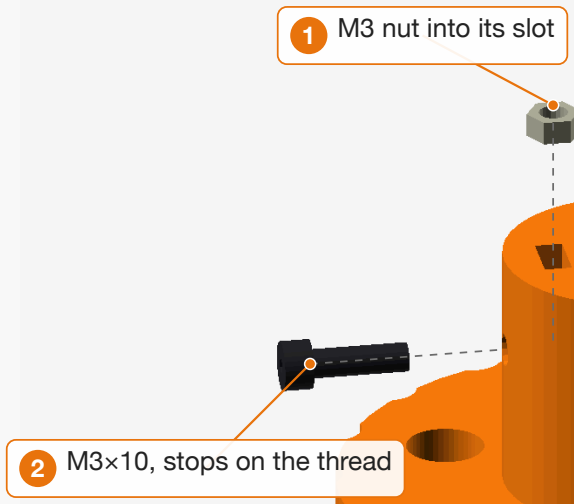
[picture p56: figure]
1 M3 nut into its slot; 2 M3×10, stops on the thread

1 Drop the M3 nut into the slot in the top of the hub. 2 Start the M3×10 from the outside, through the nut.

### 3 M5×60 up through the rim from below, head in the

4 Nut on top of the rim, tight: the bolt mustn’t turn.

### 5 Two nuts above the sleeve, locked against each

other. Leave a little play so the sleeve spins.

### 3 M5×60 up from below

4

sleeve

5

two nuts locked together

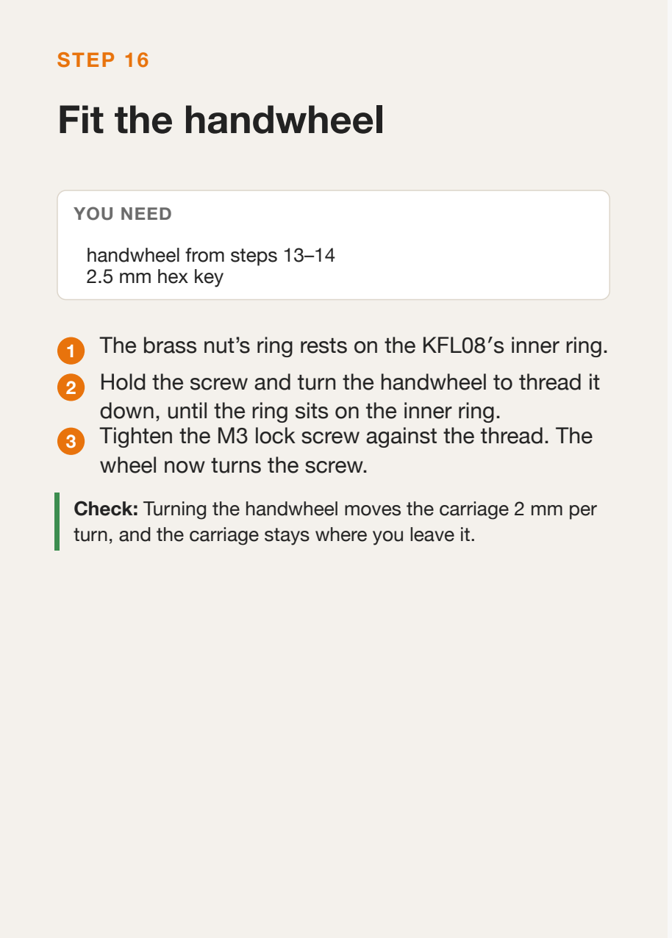
[picture p57: figure]
STEP 16 Fit the handwheel; YOU NEED; handwheel from steps 13–14 2.5 mm hex key; wheel now turns the screw.

1 The brass nut’s ring rests on the KFL08′s inner ring.

### 2 Hold the screw and turn the handwheel to thread it

down, until the ring sits on the inner ring.

### 3 Tighten the M3 lock screw against the thread. The

Check: Turning the handwheel moves the carriage 2 mm per turn, and the carriage stays where you leave it.

1

inner race

2

### 3 thread it down then lock

STEP 17

## Line up and tighten the bearings

YOU NEED

4 mm hex key, 8 mm spanner

### 1 Wind the carriage near the top. Tighten the top

KFL08′s bolts where the bearing has settled.

### 2 Wind it near the bottom. Tighten the bottom

KFL08′s bolts the same way.

Check: Run the full travel: no tight spots and the screw doesn’t whip. If one end binds, loosen that bearing, let it settle, and retighten.

Carriage centre travels from about 160 to 420 mm. The brackets are the end stops, so don’t wind hard into them. An O-ring on the screw at each end makes a good bumper.

1

top KFL08 bolts

### 2 bottom KFL08 bolts

carriage

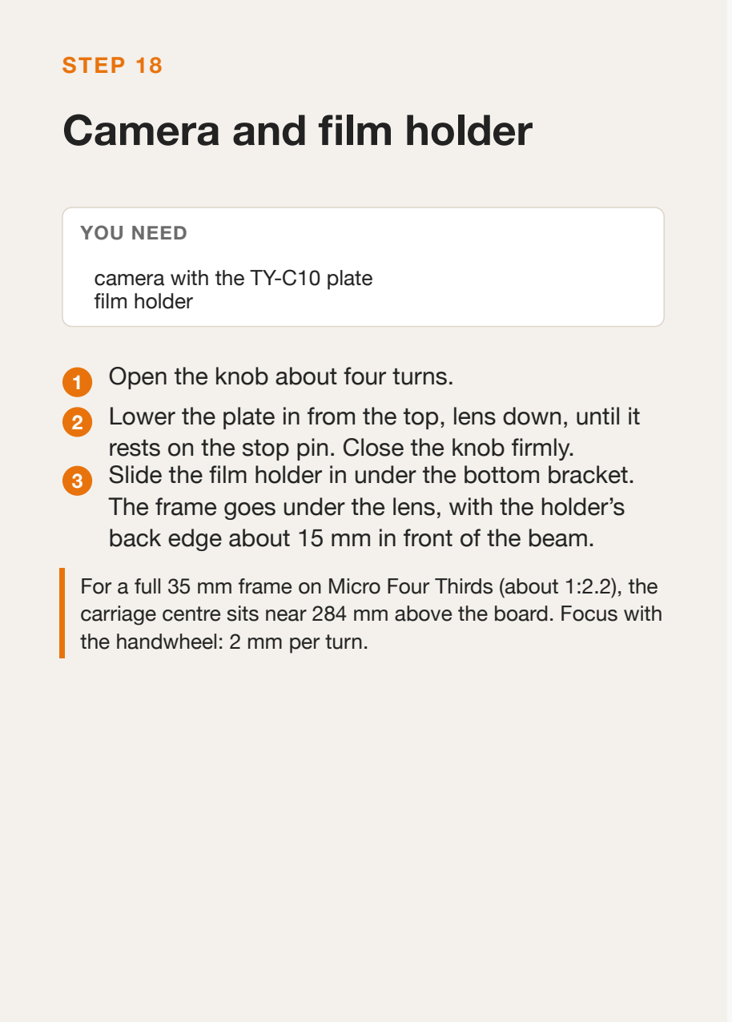
[picture p58: figure]
STEP 18 Camera and film holder; YOU NEED; camera with the TY-C10 plate film holder; 1 Open the knob about four turns.; the handwheel: 2 mm per turn.

### 2 Lower the plate in from the top, lens down, until it

rests on the stop pin. Close the knob firmly.
3 Slide the film holder in under the bottom bracket. The frame goes under the lens, with the holder’s back edge about 15 mm in front of the beam.

For a full 35 mm frame on Micro Four Thirds (about 1:2.2), the carriage centre sits near 284 mm above the board. Focus with

1

knob

### 2 plate in from the top

3

film holder under the bracket
