thgeorgiou/ai-copy-stand/renders/assembly_iso.png

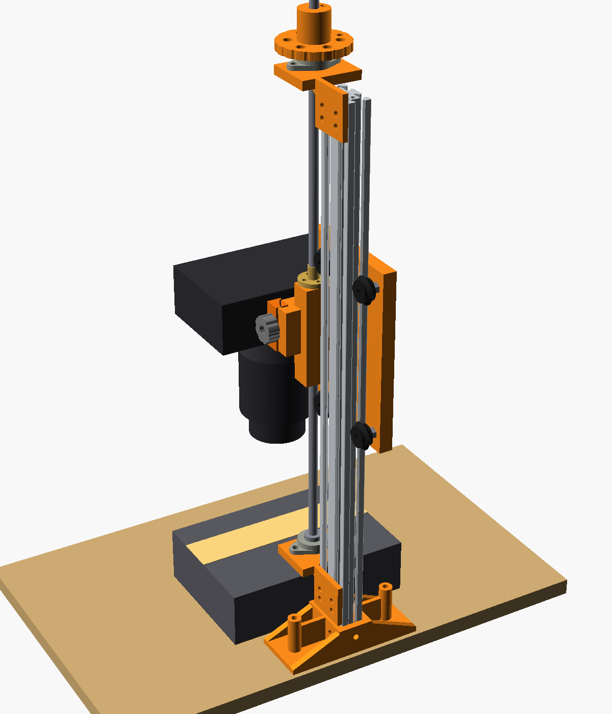
renders/assembly_iso.png
