thgeorgiou/ai-copy-stand/renders/assembly_side.png

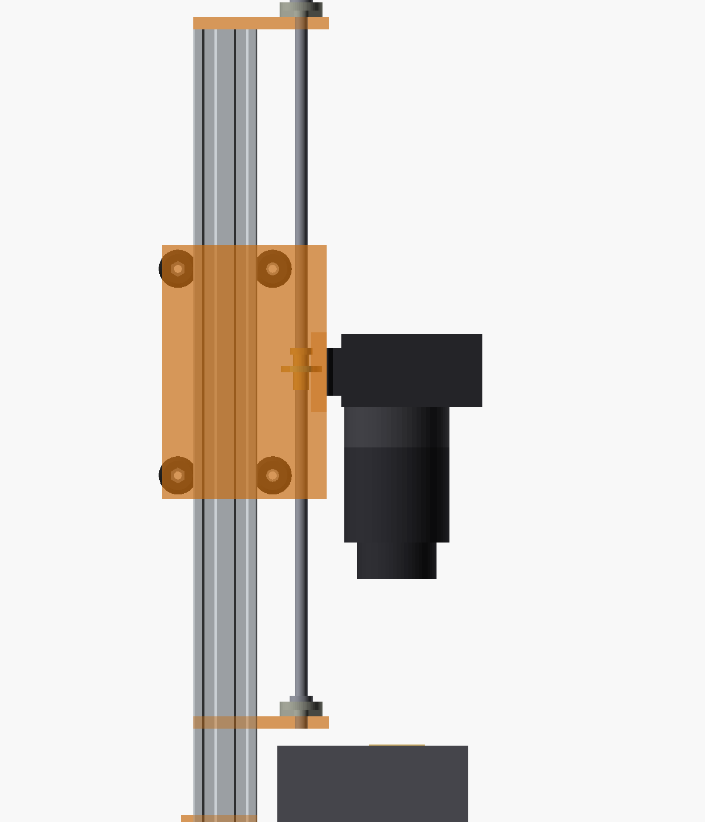
renders/assembly_side.png
