thgeorgiou/ai-copy-stand/renders/p0c_print.png

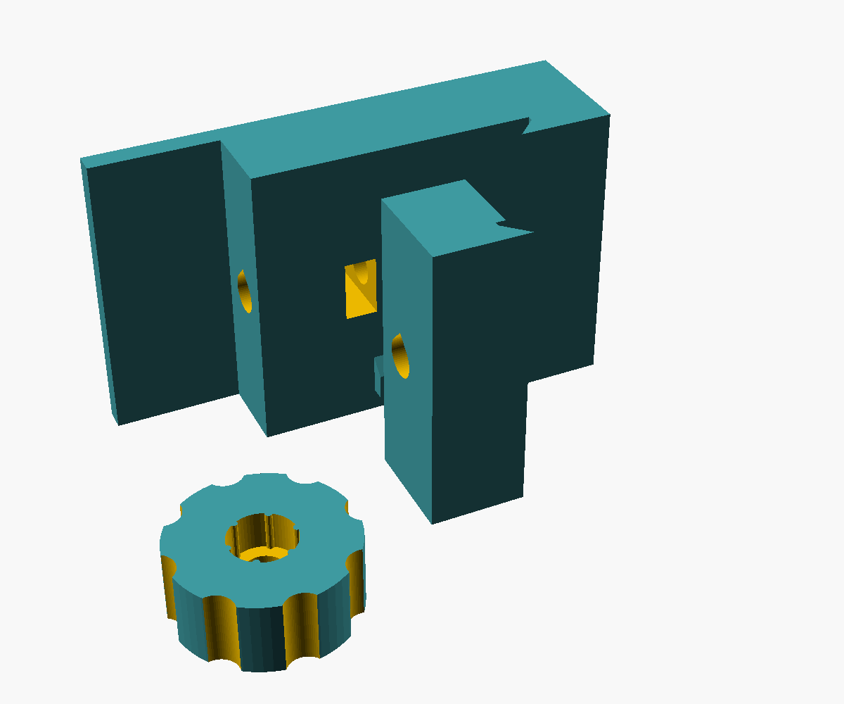
renders/p0c_print.png
