thgeorgiou/ai-copy-stand/renders/p1_print.png

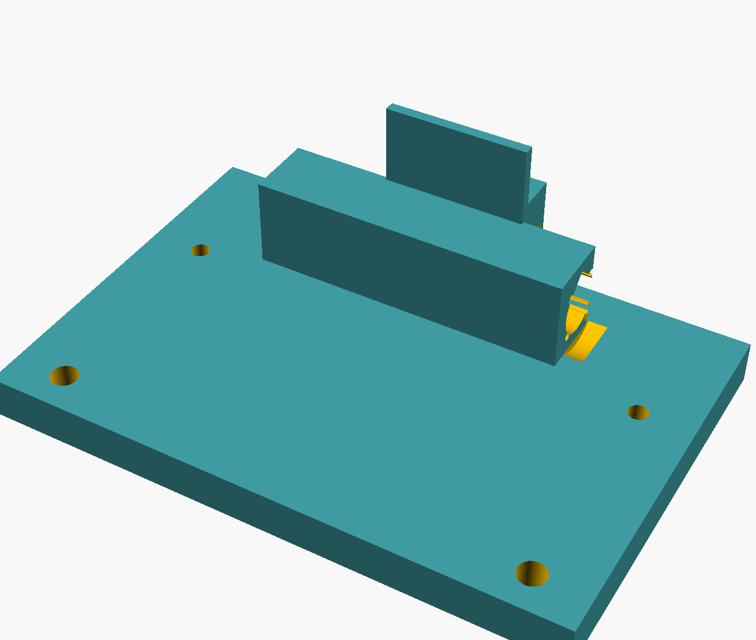
renders/p1_print.png
