thgeorgiou/ai-copy-stand/(commit log)

2026-10-19 Add LICENSE
    [vitamins.scad]
2026-10-31 Fix anti-backlash nut model and carriage bore
    The nut has a flat flange with the body, spring and keyed end piece
    (14 mm collar) all on one side, 27 mm overall. Redraw ab_nut() to match
    and replace the old body/spring parameters.
    P1 gets a stepped bore: a 13 mm neck that just passes the collar and
    keeps the M3 pilots walled in, opening up below so the collar floats.
    Pilots are 2.5 mm, 13 mm deep, with a lead-in. Update the fitting
    instructions in step s08.
    [p1_carriage.scad, p1_carriage.stl, params.scad, vitamins.scad]
2026-10-31 Add P8 board feet
    P6's board bolts leave washers and nuts 7.5 mm under the board, so it
    rocks. Four 12 mm feet, 25 mm in from each corner, lift it 4.5 mm clear.
    Each takes a 3.5x16 countersunk wood screw (or glue/VHB).
    Share board_bolt_len/tail between P6 and P8, show the feet in the
    assembly, add a "Fit the feet" step to the guide, update the README,
    and rebuild the guide PDF.
    [assembly.scad, p6_foot.scad, p8_board_feet.scad, p8_board_feet.stl, params.scad, params_echo.scad]
2026-10-31 Make a note about the arca-swiss mount
